maxtom400-lab/Electric-piano-tuning/notes/545.jpg

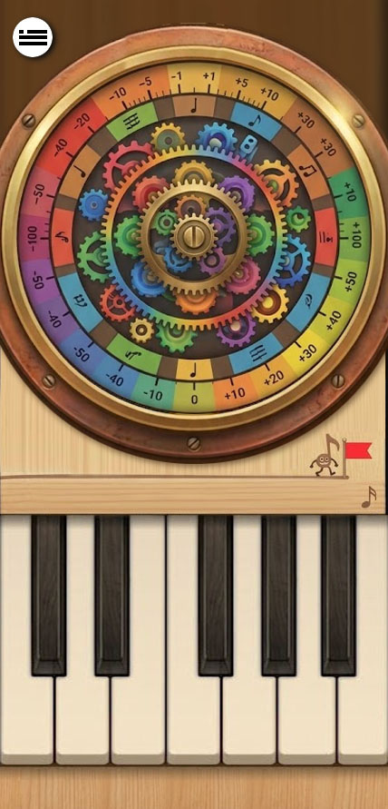
notes/545.jpg
