maxtom400-lab/Electric-piano-tuning/HARDWARE.md

# Hardware Reference

## Current ESP32-C3 Prototype

The current app and firmware target an ESP32-C3 SuperMini named `troy high school`, a separate 12V DC motor driver, and two limit switches connected directly to GPIO6/GPIO7. GPIO4/GPIO5 control the driver's IN1/IN2. A 12V-to-5V buck converter powers the ESP32; all grounds are common.

This new hardware combination awaits bench testing. The current timing model assumes 60 RPM, not the older 90 RPM value below. See [firmware wiring and test instructions](firmware/esp32_c3_piano_motor/README.md).

## Earlier Vendor-Board Setup

This project was developed and tested with a small BLE DC motor controller board and a 12V geared brushed DC motor.

## Purchase Reference Links

These links are provided only as purchase/reference information. Product pages, SKU names, and seller details may change over time.

- BLE motor driver board: https://item.taobao.com/item.htm?id=583203325716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
- 12V geared DC motor: https://item.taobao.com/item.htm?id=1038629212708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
- Piano rib mounting bracket: https://detail.tmall.com/item.htm?id=804404331380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

## Known BLE Board Details

- BLE name: `JUXUN-88888888`
- BLE address observed during testing: `DE:AB:BD:EA:2F:DE`
- Write characteristic: `0000ffe2-0000-1000-8000-00805f9b34fb`
- Notify characteristic: `0000ffe1-0000-1000-8000-00805f9b34fb`

See `PROTOCOL.md` for the actual command bytes, speed command, stop command, heartbeat, and left/right limit switch notifications.

## Motor Notes

- Motor type: 12V geared brushed DC motor
- Approximate speed used in the app safety text: 90 RPM
- The app uses hold-to-run manual controls and guarded automatic pulses.

## Mounting Notes

- The mounting bracket is intended to clamp/fix the mechanism to a piano rib.
- Verify that the bracket cannot slide before using automatic motor pulses.
- Do not rely on software limits alone; the mechanical setup should stay stable if the phone disconnects or the motor stops late.

## Safety

Piano tuning strings can break if the motor keeps pulling in the wrong direction. Always test with a safe mechanical setup, working limit switches, and a manual stop path.
