maxtom400-lab/Electric-piano-tuning/notes/ble-protocol.md

# BLE 协议记录

把 nRF Connect 或本 APP 发现的信息记录在这里。

```text
设备名: JUXUN-88888888
MAC 地址: DE:AB:BD:EA:2F:DE
Service UUID:
Characteristic UUID:
Properties: Write / Write Without Response / Notify

已从手机系统日志确认:

```text
控制 Service UUID: 0000ffe0-0000-1000-8000-00805f9b34fb
写入 Characteristic UUID: 0000ffe2-0000-1000-8000-00805f9b34fb
写入 Handle: 0x0021
写入属性: Write Without Response, prop=0x04
通知 Characteristic UUID: 0000ffe1-0000-1000-8000-00805f9b34fb
通知属性: Notify / Indicate, prop=0x18
店家微信小程序写入长度: 常见 8 字节或 9 字节
```

正转指令:
停止指令:
反转指令:
速度加:
速度减:
```
