maxtom400-lab/Electric-piano-tuning/docs/PIANO.docx

有刷电机性能参数，网址为参考地址：https://item.taobao.com/item.htm?id=1038629212708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

采用2头出轴的并且有M6螺纹的样式，电机与支架一起，支架固定在电机上，支架另一段可以安装卡住调律扳手的U型槽。电机参数：12v电源90转。

钢琴琴弦标准回转扭矩13 ~ 20 N·m维持音准所需的最小静摩擦阻力矩。通过“螺杆加长栓”结构将电机的旋转转化为直线运动，再通过 U 型卡槽推拉调律扳手。同时，利用带有自润滑圈的圆柱与台钳连接，完美解决了调律扳手在弧线运动时的多自由度释放（防止卡死）问题，橡胶垫设计也有效保护了钢琴昂贵的铸铁牌骨架。通过严密的力学和物理公式进行推导和计算：

一、 核心力学计算与可行性评估

1. 电机通过 M6 螺纹能产生多大推力（直线拉力）？

电机两端为 M6 螺栓轴。标准 M6 螺纹的螺距（Pitch）为 1 mm（即电机每转一圈，直线移动 1 毫米）。
根据机械传动公式，螺杆产生的直线推力 F 与输入扭矩 T 的关系为：

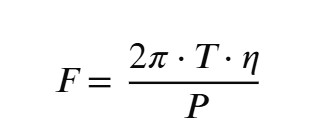
[picture p2: figure]

T (额定扭矩) = 2 kgf·cm = 0.196 N·m

- P (螺距) = 1 mm = 0.001 m
- η (由于是普通 M6 螺纹并非滚珠丝杠，滑动摩擦力较大，机械效率 η 约取 0.3)

代入公式计算：
N

- 额定状态下：电机能产生约 37 公斤（369 N） 的直线推力。
- 堵转状态下：扭矩提升 3 倍（6 kgf·cm），最大极限推力可达约 110 公斤。

2. 推力作用在调律扳手上，能产生多大调音扭矩？

根据上一轮的行业科普，钢琴调律需要 13 ~ 20 N·m 的回转扭矩。
假设您的 U 型卡槽固定在调律扳手柄的中后段（假设力臂 L = 0.2 米，即距离弦轴中心 20 厘米处）：

- 额定输出扭矩 = 369NX0.2m= 73.8 N·m
- 极限堵转扭矩 =110公斤X 0.2m≈220N·m
- 结论：动力完全过剩（绝对带得动）

调音仅需 13~20 N·m，而该电机通过 M6 螺纹放大后，额定即可输出 73.8 N·m 的扭矩。这意味着这款电机的力量绰绰有余，甚至可以轻松调准长期未调、极为紧实的高端新琴。

最大摆动角度： 8 厘米行程可带动的扳手最大摆角约为 23度（正负约 \11.5度）。

控制分辨率（每秒转角）： 电机每秒移动 1.16 毫米，对应扳手每秒仅转动 \0.33度

因为钢琴存在“音响不协和性”（Inharmonicity），高音需要偏高、低音需要偏低，不能照搬物理绝对频率。先录制 88 键，可以生成专属于这台钢琴的皮亚诺调律曲线（曲线拉伸图）。移植开源算法：关键两点

1、 录完 88 键后，App 应自动比对国际标准十二平均律（A4=440Hz）。

2、 算法将根据这台琴特有的物理状态（如弦长、张力），自动计算出高音区应调高多少音分（Cents），低音区应调低多少音分，形成一条平滑的调律曲线（Stretched Tuning Curve），作为下一步单独调律的目标基准线。

手机监听钢琴的频率，到达可接受范围停止调节，APP指针指向0的时候就说明该按键已经调节完毕。
