maxtom400-lab/Electric-piano-tuning/app/src/main/java/com/example/bluetoothmotor/MainActivity.java

package com.example.bluetoothmotor;

import android.Manifest;
import android.annotation.SuppressLint;
import android.app.Activity;
import android.app.AlertDialog;
import android.bluetooth.BluetoothAdapter;
import android.bluetooth.BluetoothDevice;
import android.bluetooth.BluetoothGatt;
import android.bluetooth.BluetoothGattCallback;
import android.bluetooth.BluetoothGattCharacteristic;
import android.bluetooth.BluetoothGattDescriptor;
import android.bluetooth.BluetoothGattService;
import android.bluetooth.BluetoothManager;
import android.bluetooth.BluetoothProfile;
import android.bluetooth.le.BluetoothLeScanner;
import android.bluetooth.le.ScanCallback;
import android.bluetooth.le.ScanResult;
import android.bluetooth.le.ScanSettings;
import android.content.Context;
import android.content.SharedPreferences;
import android.content.pm.PackageManager;
import android.graphics.Canvas;
import android.graphics.Color;
import android.graphics.Bitmap;
import android.graphics.BitmapFactory;
import android.graphics.Paint;
import android.graphics.LinearGradient;
import android.graphics.RadialGradient;
import android.graphics.Rect;
import android.graphics.RectF;
import android.graphics.Shader;
import android.media.AudioFormat;
import android.media.AudioManager;
import android.media.AudioRecord;
import android.media.AudioTrack;
import android.media.MediaRecorder;
import android.os.Build;
import android.os.Bundle;
import android.os.Handler;
import android.os.Looper;
import android.os.SystemClock;
import android.os.VibrationEffect;
import android.os.Vibrator;
import android.text.InputFilter;
import android.text.InputType;
import android.util.Log;
import android.view.Gravity;
import android.view.MotionEvent;
import android.view.View;
import android.widget.Button;
import android.widget.EditText;
import android.widget.LinearLayout;
import android.widget.ScrollView;
import android.widget.TextView;
import android.widget.Toast;

import java.io.ByteArrayOutputStream;
import java.io.IOException;
import java.io.InputStream;
import java.util.ArrayList;
import java.util.ArrayDeque;
import java.util.List;
import java.util.Locale;
import java.util.UUID;

public class MainActivity extends Activity {
    private static final String TAG = "PianoTuner";
    private static final int REQUEST_PERMISSIONS = 1001;
    private static final long SCAN_MS = 20_000L;
    private static final long HEARTBEAT_MS = 10 * 60 * 1000L;
    private static final int PIANO_SCAN_SAMPLES_REQUIRED = 3;
    private static final int SAMPLE_RATE = FftPitchDetector.SAMPLE_RATE;
    private static final int PITCH_BUFFER_SIZE = FftPitchDetector.FRAME_SIZE;
    private static final double TUNER_DIAL_CENTS_RANGE = 200.0;
    private static final float TUNER_DIAL_DEGREES_RANGE = 270f;
    private static final float TUNER_DIAL_DEGREES_PER_CENT =
            (float) (TUNER_DIAL_DEGREES_RANGE / TUNER_DIAL_CENTS_RANGE);
    private static final double AUTO_TOLERANCE_CENTS = 3.0;
    private static final int AUTO_MAX_STEPS = 40;
    private static final int AUTO_NOTE_WINDOW_SEMITONES = 2;
    private static final double EXPERIENCE_MOTOR_RPM = 60.0;
    private static final double EXPERIENCE_REV_MS = 60000.0 / EXPERIENCE_MOTOR_RPM;
    private static final double EXPERIENCE_PIN_DEGREES_PER_REV = 0.28;
    private static final double MOTOR_TOTAL_TRAVEL_REV = 40.0;
    private static final double MOTOR_INIT_BACKOFF_REV = 10.0;
    private static final long MOTOR_INIT_SEEK_TIMEOUT_MS = 120_000L;
    private static final long MOTOR_INIT_LIMIT_DEBOUNCE_MS = 1_000L;
    private static final double EXPERIENCE_LOW_CENTS_PER_REV = 2.8;
    private static final double EXPERIENCE_MID_CENTS_PER_REV = 4.5;
    private static final double EXPERIENCE_HIGH_CENTS_PER_REV = 12.6;
    private static final int EXPERIENCE_LOW_MIDI = 21;
    private static final int EXPERIENCE_MID_MIDI = 60;
    private static final int EXPERIENCE_HIGH_MIDI = 108;
    private static final int[] EXPERIENCE_CURVE_MIDI = {
            EXPERIENCE_LOW_MIDI,
            EXPERIENCE_MID_MIDI,
            EXPERIENCE_HIGH_MIDI
    };
    private static final double[] EXPERIENCE_CURVE_CENTS_PER_REV = {
            EXPERIENCE_LOW_CENTS_PER_REV,
            EXPERIENCE_MID_CENTS_PER_REV,
            EXPERIENCE_HIGH_CENTS_PER_REV
    };
    private static final int EXPERIENCE_MIN_PULSE_MS = 60;
    private static final int EXPERIENCE_DEFAULT_MAX_PULSE_MS = 12000;
    private static final double DEFAULT_PRELOAD_LOW_REV = 6.0;
    private static final long EXPERIENCE_RESTRIKE_ARM_MS = 450L;
    private static final int WRONG_KEY_ALLOWED_SEMITONES = 2;
    private static final long SAFETY_VIBRATION_COOLDOWN_MS = 900L;

    private enum Direction {
        NONE,
        LEFT,
        RIGHT
    }

    private static final String TARGET_NAME = "troy high school";

    private static final UUID WRITE_UUID =
            UUID.fromString("0000ffe2-0000-1000-8000-00805f9b34fb");
    private static final UUID NOTIFY_UUID =
            UUID.fromString("0000ffe1-0000-1000-8000-00805f9b34fb");
    private static final UUID CCCD_UUID =
            UUID.fromString("00002902-0000-1000-8000-00805f9b34fb");

    private static final String CMD_INIT = "AF010203040506FF";
    private static final String CMD_LEFT = "A1010100000002321F";
    private static final String CMD_STOP = "A10102000000011F";
    private static final String CMD_RIGHT = "A1020100000002321F";
    private static final String CMD_SPEED_50 = "A1080132";
    private static final String CMD_SPEED_30 = "A108011E";
    private static final String CMD_SPEED_STEP = CMD_SPEED_50;
    private static final String PREFS_NAME = "max_piano_tuner";

    private final Handler handler = new Handler(Looper.getMainLooper());
    private final SafeMotorSession safeMotor = new SafeMotorSession();
    private final PianoStrikeGate motorStrikeGate = new PianoStrikeGate();
    private final ArrayDeque<MotorWrite> motorWrites = new ArrayDeque<>();
    private MotorWrite activeMotorWrite;
    private long motorWriteTicket;
    private boolean activityPaused;

    private static final class MotorWrite {
        final String label;
        final byte[] payload;
        final int generation;
        final BluetoothGatt owner;
        final boolean stop;
        MotorWrite(String label, byte[] payload, int generation, BluetoothGatt owner, boolean stop) {
            this.label = label;
            this.payload = payload;
            this.generation = generation;
            this.owner = owner;
            this.stop = stop;
        }
    }
    private final Runnable heartbeatRunnable = new Runnable() {
        @Override
        public void run() {
            if (gatt != null && writeCharacteristic != null) {
                sendCommand("HEARTBEAT", CMD_INIT);
                handler.postDelayed(this, HEARTBEAT_MS);
            }
        }
    };

    private BluetoothAdapter adapter;
    private BluetoothLeScanner scanner;
    private BluetoothDevice targetDevice;
    private BluetoothGatt gatt;
    private BluetoothGattCharacteristic writeCharacteristic;
    private boolean scanning;
    private boolean connectAfterScan;
    private AlertDialog motorDialog;

    private TextView statusText;
    private TextView notifyText;
    private TextView pitchText;
    private TextView targetText;
    private TextView autoText;
    private SteampunkTunerView tunerView;
    private PianoKeyPlayer pianoKeyPlayer;
    private TextView logText;
    private EditText rawInput;
    private EditText repeatInput;
    private Runnable activeMotionRunnable;
    private int commandGeneration;
    private String pendingFreshLabel;
    private String pendingFreshHex;
    private long pendingFreshMotionDelayMs;
    private int pendingFreshRepeatCount;
    private long pendingFreshRepeatIntervalMs;
    private int pendingFreshSpeedCount;
    private long pendingFreshSpeedStartMs;
    private long pendingFreshSpeedIntervalMs;
    private long pendingFreshStopExtraMs;
    private boolean reconnectAfterDisconnect;
    private boolean pendingReplayVendorLr;
    private boolean replayVendorLrAfterInitAck;
    private Direction currentDirection = Direction.NONE;
    private Direction blockedDirection = Direction.NONE;
    private Direction motorSafetyBackoffOriginLimit = Direction.NONE;
    private long motorSafetySeekStartedAtMs;
    private AudioRecord audioRecord;
    private Thread audioThread;
    private volatile boolean listening;
    private volatile int audioGeneration;
    private volatile double latestFrequency;
    private volatile int latestMidi;
    private volatile double latestCents;
    private volatile long latestPitchMs;
    private volatile double latestStableFrequency;
    private volatile int latestStableMidi;
    private volatile double latestStableCents;
    private volatile long latestStablePitchMs;
    private int selectedTargetMidi = 60;
    private long suppressPitchUpdateUntilMs;
    private long suppressRangeAlarmUntilMs;
    private double pitchCandidateCents;
    private int pitchCandidateFrames;
    private long pitchCandidateStartedMs;
    private boolean autoTuning;
    private int autoGeneration;
    private int autoTargetMidi;
    private double autoTargetFrequency;
    private double autoProbeFrequency;
    private Direction autoRaiseDirection = Direction.NONE;
    private Direction autoLowerDirection = Direction.NONE;
    private int autoStepCount;
    private int autoSpeedPercent = 50;
    private int autoProbeMs = 350;
    private int autoPulseLongMs = 450;
    private int autoPulseMediumMs = 250;
    private int autoPulseShortMs = 120;
    private int autoSettleMs = 1400;
    private int autoMaxStepsSetting = AUTO_MAX_STEPS;
    private double autoToleranceCents = AUTO_TOLERANCE_CENTS;
    private int autoExperienceMaxPulseMs = EXPERIENCE_DEFAULT_MAX_PULSE_MS;
    private double autoPreloadLowRev = DEFAULT_PRELOAD_LOW_REV;
    private boolean autoWaitingForRestrike;
    private long autoIgnorePitchBeforeMs;
    private double autoLastObservedCents;
    private double autoLastExpectedDeltaCents;
    private int autoLastDurationMs;
    private Direction autoLastDirection = Direction.NONE;
    private final double[] autoExperienceScale = new double[109];
    private boolean motorSafetyInitInProgress;
    private boolean motorSafetyBackoffInProgress;
    private boolean motorSafetyInitialized;
    private int motorSafetyInitializedMidi;
    private double motorPositionRevFromLow = Double.NaN;
    private boolean autoArmedForPianoStrike;
    private long lastSafetyVibrateMs;
    private boolean keyPreviewEnabled;
    private long lastRangeAlarmVibrateMs;
    private AlertDialog pianoScanDialog;
    private TextView pianoScanStatusText;
    private TextView pianoScanProgressText;
    private boolean pianoScanActive;
    private int pianoScanMidi = 21;
    private int pianoScanCount;
    private long pianoScanLastRecordMs;
    private int pianoScanSampleCount;
    private String pianoScanQuality = "Waiting";
    private final boolean[] pianoScanRecorded = new boolean[109];
    private final double[] pianoScanFrequency = new double[109];
    private final double[] pianoScanCents = new double[109];
    private final double[] pianoScanSampleFrequency = new double[PIANO_SCAN_SAMPLES_REQUIRED];
    private final double[] pianoScanSampleCents = new double[PIANO_SCAN_SAMPLES_REQUIRED];
    private final double[] pianoTuningOffsetCents = new double[109];
    private boolean pianoTuningComputed;

    private final ScanCallback scanCallback = new ScanCallback() {
        @SuppressLint("MissingPermission")
        @Override
        public void onScanResult(int callbackType, ScanResult result) {
            BluetoothDevice device = result.getDevice();
            if (device == null || device.getAddress() == null) {
                return;
            }

            String name = safeDeviceName(device);
            String advertisedName = result.getScanRecord() == null ? null : result.getScanRecord().getDeviceName();
            String bestName = firstNonEmpty(advertisedName, name);
            boolean nameMatch = isTargetMotorName(name) || isTargetMotorName(advertisedName);
            if (bestName != null && (nameMatch || bestName.length() > 0)) {
                appendLogSafe(String.format(Locale.US,
                        "BLE scan %s name=%s adv=%s rssi=%d match=%s",
                        device.getAddress(),
                        valueOrDash(name),
                        valueOrDash(advertisedName),
                        result.getRssi(),
                        nameMatch));
            }
            if (!nameMatch) {
                return;
            }

            targetDevice = device;
            runOnUiThread(() -> {
                setStatus("已找到蓝牙电机板");
                appendLog("找到目标设备 " + deviceLabel(device));
                if (connectAfterScan) {
                    connectAfterScan = false;
                    stopScan();
                    showMotorDialog("正在连接蓝牙电机板...");
                    connectTarget();
                }
            });
        }

        @Override
        public void onScanFailed(int errorCode) {
            runOnUiThread(() -> {
                scanning = false;
                connectAfterScan = false;
                dismissMotorDialog();
                setStatus("蓝牙扫描失败: " + errorCode);
            });
        }
    };

    private final BluetoothGattCallback gattCallback = new BluetoothGattCallback() {
        @SuppressLint("MissingPermission")
        @Override
        public void onConnectionStateChange(BluetoothGatt owner, int status, int newState) {
            runOnUiThread(() -> {
                if (MainActivity.this.gatt != owner) {
                    if (newState == BluetoothProfile.STATE_DISCONNECTED) owner.close();
                    return;
                }
                if (newState == BluetoothProfile.STATE_CONNECTED && status == BluetoothGatt.GATT_SUCCESS && !activityPaused) {
                    setStatus("蓝牙已连接，正在发现服务");
                    showMotorDialog("正在发现电机服务...");
                    if (!owner.discoverServices()) motorTransportFailure("Service discovery rejected");
                } else if (newState == BluetoothProfile.STATE_DISCONNECTED) {
                    owner.close();
                    MainActivity.this.gatt = null;
                    writeCharacteristic = null;
                    motorWrites.clear();
                    activeMotorWrite = null;
                    motorWriteTicket++;
                    cancelScheduledCommands();
                    stopAutoTune(false);
                    clearMotorPosition();
                    safeMotor.disconnected();
                    stopHeartbeat();
                    dismissMotorDialog();
                    pendingFreshHex = null;
                    pendingReplayVendorLr = false;
                    reconnectAfterDisconnect = false;
                    setStatus("蓝牙已断开；重新连接后需要重新初始化");
                } else if (status != BluetoothGatt.GATT_SUCCESS || activityPaused) {
                    motorTransportFailure("Bluetooth connection failed: " + status);
                }
            });
        }

        @Override
        public void onServicesDiscovered(BluetoothGatt owner, int status) {
            runOnUiThread(() -> {
                if (owner != MainActivity.this.gatt || activityPaused) return;
                if (status != BluetoothGatt.GATT_SUCCESS) {
                    motorTransportFailure("Service discovery failed: " + status);
                    return;
                }
                BluetoothGattCharacteristic write = null;
                BluetoothGattCharacteristic notify = null;
                for (BluetoothGattService service : owner.getServices()) {
                    for (BluetoothGattCharacteristic c : service.getCharacteristics()) {
                        if (WRITE_UUID.equals(c.getUuid())) write = c;
                        if (NOTIFY_UUID.equals(c.getUuid())) notify = c;
                    }
                }
                if (write == null || notify == null
                        || (write.getProperties() & BluetoothGattCharacteristic.PROPERTY_WRITE) == 0) {
                    motorTransportFailure("Safe controller requires FFE2 write-with-response and FFE1 notifications");
                    return;
                }
                writeCharacteristic = write;
                enableNotifications(owner, notify);
            });
        }

        @Override
        public void onDescriptorWrite(BluetoothGatt owner, BluetoothGattDescriptor descriptor, int status) {
            runOnUiThread(() -> {
                if (owner != MainActivity.this.gatt || activityPaused) return;
                if (status != BluetoothGatt.GATT_SUCCESS || !CCCD_UUID.equals(descriptor.getUuid())) {
                    motorTransportFailure("Notification subscription failed: " + status);
                    return;
                }
                sendCommand("SAFE CAPABILITIES", SafeMotorSession.CAPABILITIES_HEX);
                startHeartbeat();
                dismissMotorDialog();
                setStatus("正在确认安全协议；未确认前禁止电机运动");
                handler.postDelayed(() -> {
                    if (owner == MainActivity.this.gatt && !safeMotor.capable() && !activityPaused) {
                        setStatus("未检测到安全协议，请升级 ESP32 固件；自动/手动电机控制已禁用");
                    }
                }, 2500L);
            });
        }

        @Override
        public void onCharacteristicWrite(BluetoothGatt owner, BluetoothGattCharacteristic characteristic, int status) {
            runOnUiThread(() -> {
                if (owner != MainActivity.this.gatt || activeMotorWrite == null
                        || activeMotorWrite.owner != owner) return;
                if (status != BluetoothGatt.GATT_SUCCESS) {
                    motorTransportFailure("BLE write failed: " + status);
                    return;
                }
                activeMotorWrite = null;
                motorWriteTicket++;
                pumpMotorWrites();
            });
        }

        @Override
        public void onCharacteristicChanged(
                BluetoothGatt gatt,
                BluetoothGattCharacteristic characteristic
        ) {
            handleNotifyValue(gatt, characteristic, characteristic.getValue());
        }

        @Override
        public void onCharacteristicChanged(
                BluetoothGatt gatt,
                BluetoothGattCharacteristic characteristic,
                byte[] value
        ) {
            handleNotifyValue(gatt, characteristic, value);
        }

    };

    @Override
    protected void onCreate(Bundle savedInstanceState) {
        super.onCreate(savedInstanceState);

        BluetoothManager manager = (BluetoothManager) getSystemService(Context.BLUETOOTH_SERVICE);
        adapter = manager == null ? null : manager.getAdapter();
        scanner = adapter == null ? null : adapter.getBluetoothLeScanner();
        pianoKeyPlayer = new PianoKeyPlayer(this);
        loadPianoScanData();
        loadCalibrationSettings();

        setContentView(buildContentView());
        requestNeededPermissions();
        if (hasAudioPermission()) {
            startPitchListening();
        }
    }

    @Override
    protected void onDestroy() {
        stopAutoTune(false);
        stopHeartbeat();
        stopPitchListening();
        stopScan();
        disconnectGatt();
        if (pianoKeyPlayer != null) {
            pianoKeyPlayer.release();
            pianoKeyPlayer = null;
        }
        super.onDestroy();
    }

    @Override
    protected void onPause() {
        activityPaused = true;
        stopPitchListening();
        cancelScheduledCommands();
        stopAutoTune(false);
        clearMotorPosition();
        motorWrites.clear();
        pendingFreshHex = null;
        pendingReplayVendorLr = false;
        reconnectAfterDisconnect = false;
        if (gatt != null) {
            sendCommand("BACKGROUND STOP", CMD_STOP);
            disconnectGatt();
        }
        super.onPause();
    }

    @Override
    protected void onResume() {
        super.onResume();
        activityPaused = false;
        if (hasAudioPermission() && tunerView != null) startPitchListening();
    }

    private View buildContentView() {
        ScrollView scrollView = new ScrollView(this);
        LinearLayout root = new LinearLayout(this);
        root.setOrientation(LinearLayout.VERTICAL);
        root.setPadding(0, 0, 0, 0);
        root.setBackgroundColor(Color.rgb(231, 204, 161));
        scrollView.addView(root);

        statusText = text("", 1, Color.TRANSPARENT, false);
        pitchText = text("", 1, Color.TRANSPARENT, false);
        targetText = text("", 1, Color.TRANSPARENT, false);
        autoText = text("", 1, Color.TRANSPARENT, false);
        notifyText = text("", 1, Color.TRANSPARENT, false);
        logText = text("", 1, Color.TRANSPARENT, false);

        tunerView = new SteampunkTunerView(this, this::handleVirtualPianoKeySelected, this::showControlPopup);
        root.addView(tunerView, new LinearLayout.LayoutParams(
                LinearLayout.LayoutParams.MATCH_PARENT,
                dp(860)
        ));

        selectTargetMidi(selectedTargetMidi);
        keyPreviewEnabled = true;

        scrollView.post(() -> scrollView.fullScroll(View.FOCUS_UP));
        return scrollView;
    }

    private TextView text(String value, int sp, int color, boolean bold) {
        TextView view = new TextView(this);
        view.setText(value);
        view.setTextSize(sp);
        view.setTextColor(color);
        view.setGravity(Gravity.START);
        view.setPadding(0, dp(6), 0, dp(6));
        if (bold) {
            view.setTypeface(android.graphics.Typeface.DEFAULT_BOLD);
        }
        return view;
    }

    private TextView label(String value) {
        return text(value, 14, Color.rgb(58, 72, 80), true);
    }

    private EditText editText(String value) {
        EditText input = new EditText(this);
        input.setSingleLine(true);
        input.setText(value);
        input.setFilters(new InputFilter[]{new InputFilter.AllCaps()});
        return input;
    }

    private LinearLayout row(View... children) {
        LinearLayout row = new LinearLayout(this);
        row.setOrientation(LinearLayout.HORIZONTAL);
        row.setGravity(Gravity.CENTER);
        row.setPadding(0, dp(4), 0, dp(4));
        for (View child : children) {
            row.addView(child);
        }
        return row;
    }

    private Button smallButton(String text, View.OnClickListener listener) {
        Button button = new Button(this);
        button.setText(text);
        button.setAllCaps(false);
        button.setTextSize(12);
        button.setTextColor(Color.rgb(45, 31, 20));
        button.setBackgroundColor(Color.rgb(219, 198, 166));
        button.setOnClickListener(listener);
        LinearLayout.LayoutParams params = new LinearLayout.LayoutParams(
                0,
                LinearLayout.LayoutParams.WRAP_CONTENT,
                1
        );
        params.setMargins(dp(3), dp(3), dp(3), dp(3));
        button.setLayoutParams(params);
        return button;
    }

    @SuppressLint("ClickableViewAccessibility")
    private Button holdButton(String text, String label, String hex) {
        Button button = smallButton(text, v -> {
        });
        button.setOnTouchListener((view, event) -> {
            switch (event.getActionMasked()) {
                case MotionEvent.ACTION_DOWN:
                    view.setPressed(true);
                    startHoldMotion(label, hex);
                    return true;
                case MotionEvent.ACTION_UP:
                case MotionEvent.ACTION_CANCEL:
                    view.setPressed(false);
                    stopHoldMotion(label);
                    return true;
                default:
                    return true;
            }
        });
        return button;
    }

    private Button popupButton(String text) {
        Button button = new Button(this);
        button.setText(text);
        button.setTextSize(18);
        button.setAllCaps(false);
        button.setTypeface(android.graphics.Typeface.DEFAULT_BOLD);
        button.setTextColor(Color.rgb(58, 38, 24));
        button.setBackgroundColor(Color.rgb(218, 178, 111));
        button.setMinHeight(dp(58));
        button.setElevation(dp(6));
        button.setPadding(dp(12), dp(8), dp(12), dp(8));
        LinearLayout.LayoutParams params = new LinearLayout.LayoutParams(
                LinearLayout.LayoutParams.MATCH_PARENT,
                LinearLayout.LayoutParams.WRAP_CONTENT
        );
        params.setMargins(0, dp(8), 0, dp(8));
        button.setLayoutParams(params);
        return button;
    }

    @SuppressLint("ClickableViewAccessibility")
    private void showControlPopup() {
        LinearLayout panel = new LinearLayout(this);
        panel.setOrientation(LinearLayout.VERTICAL);
        panel.setPadding(dp(22), dp(18), dp(22), dp(18));
        panel.setBackgroundColor(Color.rgb(232, 198, 139));

        Button connect = popupButton("连接蓝牙电机板");
        connect.setOnClickListener(v -> connectOnce());
        panel.addView(connect);

        Button left = popupButton("HOLD LEFT");
        left.setOnTouchListener((view, event) -> {
            switch (event.getActionMasked()) {
                case MotionEvent.ACTION_DOWN:
                    view.setPressed(true);
                    startHoldMotion("LEFT", CMD_LEFT);
                    return true;
                case MotionEvent.ACTION_UP:
                case MotionEvent.ACTION_CANCEL:
                    view.setPressed(false);
                    stopHoldMotion("LEFT");
                    return true;
                default:
                    return true;
            }
        });
        panel.addView(left);

        Button right = popupButton("HOLD RIGHT");
        right.setOnTouchListener((view, event) -> {
            switch (event.getActionMasked()) {
                case MotionEvent.ACTION_DOWN:
                    view.setPressed(true);
                    startHoldMotion("RIGHT", CMD_RIGHT);
                    return true;
                case MotionEvent.ACTION_UP:
                case MotionEvent.ACTION_CANCEL:
                    view.setPressed(false);
                    stopHoldMotion("RIGHT");
                    return true;
                default:
                    return true;
            }
        });
        panel.addView(right);

        Button record88 = popupButton("Record 88 Keys");
        record88.setOnClickListener(v -> showPianoScanDialog());
        panel.addView(record88);

        Button auto = popupButton("Auto Tune Selected Key");
        auto.setOnClickListener(v -> showAutoSafetyDialog());
        panel.addView(auto);

        Button stopAuto = popupButton("Stop Auto Tune");
        stopAuto.setOnClickListener(v -> stopAutoTune(true));
        panel.addView(stopAuto);

        Button calibration = popupButton("Calibration");
        calibration.setOnClickListener(v -> showCalibrationDialog());
        panel.addView(calibration);

        Button about = popupButton("About");
        about.setOnClickListener(v -> showAboutDialogClean());
        panel.addView(about);

        AlertDialog dialog = new AlertDialog.Builder(this)
                .setTitle("Motor Control")
                .setView(panel)
                .create();
        dialog.setOnDismissListener(d -> stopAllCommands());
        dialog.show();
    }

    private void showAboutDialog() {
        new AlertDialog.Builder(this)
                .setTitle("About")
                .setMessage("The motor is a 12V gear motor with a speed of 90 RPM. On the app's tuning dial, the 12 o'clock position (zero mark) indicates correct pitch; the range extends 170 degrees to the left and 170 degrees to the right, representing the full tuning span. The app will trigger an alarm if these limits are exceeded, so please adjust carefully—I accept no liability for broken strings.\n\nTORY HIGH SCHOOL MAX.YING 2026.")
                .setPositiveButton("OK", null)
                .show();
    }

    private void showAboutDialogClean() {
        new AlertDialog.Builder(this)
                .setTitle("About")
                .setMessage("The motor is a 12V gear motor with a speed of 90 RPM. On the app's tuning dial, the 12 o'clock position (zero mark) indicates correct pitch; the range extends 170 degrees to the left and 170 degrees to the right, representing the full tuning span. The app will trigger an alarm if these limits are exceeded, so please adjust carefully - I accept no liability for broken strings.\n\nTORY HIGH SCHOOL MAX.YING 2026.")
                .setPositiveButton("OK", null)
                .show();
    }

    private void showAutoSafetyDialog() {
        String note = noteName(selectedTargetMidi);
        new AlertDialog.Builder(this)
                .setTitle("Auto Tune Safety")
                .setMessage("Before starting automatic tuning:\n\n"
                        + "1. The piano rib bracket is locked and cannot slide.\n"
                        + "2. Left and right limit switches have been tested.\n"
                        + "3. Manual HOLD LEFT and HOLD RIGHT work correctly.\n"
                        + "4. The selected key is " + note + ". Play this key until the pitch display is stable.\n"
                        + "5. Experience mode assumes LEFT lowers pitch and RIGHT raises pitch.\n\n"
                        + "The app will calculate one motor move from the learned cents/rotation map, then wait for the next physical key strike to refine the next move. Stop immediately if the mechanism moves unexpectedly.")
                .setNegativeButton("Cancel", null)
                .setPositiveButton("Start Auto Tune", (dialog, which) -> startAutoTune())
                .show();
    }

    private void showCalibrationDialog() {
        LinearLayout panel = new LinearLayout(this);
        panel.setOrientation(LinearLayout.VERTICAL);
        panel.setPadding(dp(18), dp(14), dp(18), dp(14));
        panel.setBackgroundColor(Color.rgb(232, 198, 139));

        EditText speed = numberEditText(autoSpeedPercent);
        EditText probe = numberEditText(autoProbeMs);
        EditText pulseLong = numberEditText(autoPulseLongMs);
        EditText pulseMedium = numberEditText(autoPulseMediumMs);
        EditText pulseShort = numberEditText(autoPulseShortMs);
        EditText settle = numberEditText(autoSettleMs);
        EditText maxSteps = numberEditText(autoMaxStepsSetting);
        EditText tolerance = decimalEditText(autoToleranceCents);
        EditText experienceMaxPulse = numberEditText(autoExperienceMaxPulseMs);
        EditText preloadLow = decimalEditText(autoPreloadLowRev);

        panel.addView(label("Speed percent (1-100)"));
        panel.addView(speed);
        panel.addView(label("Probe pulse ms"));
        panel.addView(probe);
        panel.addView(label("Long pulse ms (>25 cents)"));
        panel.addView(pulseLong);
        panel.addView(label("Medium pulse ms (10-25 cents)"));
        panel.addView(pulseMedium);
        panel.addView(label("Short pulse ms (<10 cents)"));
        panel.addView(pulseShort);
        panel.addView(label("Settle time after pulse ms"));
        panel.addView(settle);
        panel.addView(label("Max auto steps"));
        panel.addView(maxSteps);
        panel.addView(label("Done tolerance cents"));
        panel.addView(tolerance);
        panel.addView(label("Experience one-shot max ms"));
        panel.addView(experienceMaxPulse);
        panel.addView(label("Preload low-direction revs"));
        panel.addView(preloadLow);

        new AlertDialog.Builder(this)
                .setTitle("Calibration")
                .setView(panel)
                .setNegativeButton("Cancel", null)
                .setNeutralButton("Defaults", (dialog, which) -> {
                    resetCalibrationDefaults();
                    saveCalibrationSettings();
                    toast("Calibration defaults restored");
                })
                .setPositiveButton("Save", (dialog, which) -> {
                    autoSpeedPercent = clampInt(parseInt(speed, autoSpeedPercent), 1, 100);
                    autoProbeMs = clampInt(parseInt(probe, autoProbeMs), 80, 1500);
                    autoPulseLongMs = clampInt(parseInt(pulseLong, autoPulseLongMs), 80, 1500);
                    autoPulseMediumMs = clampInt(parseInt(pulseMedium, autoPulseMediumMs), 60, 1000);
                    autoPulseShortMs = clampInt(parseInt(pulseShort, autoPulseShortMs), 40, 800);
                    autoSettleMs = clampInt(parseInt(settle, autoSettleMs), 500, 5000);
                    autoMaxStepsSetting = clampInt(parseInt(maxSteps, autoMaxStepsSetting), 3, 120);
                    autoToleranceCents = clampDouble(parseDouble(tolerance, autoToleranceCents), 0.5, 20.0);
                    autoExperienceMaxPulseMs = clampInt(parseInt(experienceMaxPulse, autoExperienceMaxPulseMs), 500, 60000);
                    autoPreloadLowRev = clampDouble(parseDouble(preloadLow, autoPreloadLowRev), 0.0, 10.0);
                    saveCalibrationSettings();
                    toast("Calibration saved");
                })
                .show();
    }

    private EditText numberEditText(int value) {
        EditText input = new EditText(this);
        input.setSingleLine(true);
        input.setText(String.valueOf(value));
        input.setInputType(InputType.TYPE_CLASS_NUMBER);
        return input;
    }

    private EditText decimalEditText(double value) {
        EditText input = new EditText(this);
        input.setSingleLine(true);
        input.setText(String.format(Locale.US, "%.1f", value));
        input.setInputType(InputType.TYPE_CLASS_NUMBER | InputType.TYPE_NUMBER_FLAG_DECIMAL);
        return input;
    }

    private void showPianoScanDialog() {
        LinearLayout panel = new LinearLayout(this);
        panel.setOrientation(LinearLayout.VERTICAL);
        panel.setPadding(dp(18), dp(14), dp(18), dp(14));
        panel.setBackgroundColor(Color.rgb(232, 198, 139));

        pianoScanStatusText = text("", 16, Color.rgb(45, 31, 20), true);
        pianoScanProgressText = text("", 13, Color.rgb(82, 56, 34), false);
        panel.addView(pianoScanStatusText);
        panel.addView(pianoScanProgressText);

        Button start = popupButton("Start / Resume Recording");
        start.setOnClickListener(v -> startPianoScan());
        panel.addView(start);

        Button prev = smallButton("Previous", v -> movePianoScanKey(-1));
        Button next = smallButton("Next", v -> movePianoScanKey(1));
        panel.addView(row(prev, next));

        Button compute = popupButton("Compute Tuning");
        compute.setOnClickListener(v -> computePianoTuningModel());
        panel.addView(compute);

        Button reset = popupButton("Reset Recording");
        reset.setOnClickListener(v -> resetPianoScan());
        panel.addView(reset);

        updatePianoScanDialog();
        pianoScanDialog = new AlertDialog.Builder(this)
                .setTitle("88-Key Recording")
                .setView(panel)
                .setPositiveButton("Close", null)
                .create();
        pianoScanDialog.setOnDismissListener(dialog -> pianoScanActive = false);
        pianoScanDialog.show();
    }

    private void startPianoScan() {
        if (!hasAudioPermission()) {
            requestNeededPermissions();
            return;
        }
        if (!listening) {
            startPitchListening();
        }
        if (pianoScanMidi < 21 || pianoScanMidi > 108) {
            pianoScanMidi = firstUnrecordedMidi();
        }
        pianoScanActive = true;
        resetPianoScanSamples("Waiting");
        selectTargetMidi(pianoScanMidi, false);
        updatePianoScanDialog();
    }

    private void resetPianoScan() {
        pianoScanActive = false;
        pianoScanMidi = 21;
        pianoScanCount = 0;
        pianoTuningComputed = false;
        resetPianoScanSamples("Waiting");
        for (int midi = 21; midi <= 108; midi++) {
            pianoScanRecorded[midi] = false;
            pianoScanFrequency[midi] = 0;
            pianoScanCents[midi] = 0;
            pianoTuningOffsetCents[midi] = 0;
        }
        savePianoScanData();
        selectTargetMidi(pianoScanMidi, false);
        updatePianoScanDialog();
    }

    private void movePianoScanKey(int delta) {
        pianoScanMidi = Math.max(21, Math.min(108, pianoScanMidi + delta));
        pianoScanActive = true;
        resetPianoScanSamples("Waiting");
        selectTargetMidi(pianoScanMidi, false);
        updatePianoScanDialog();
    }

    private void updatePianoScanDialog() {
        if (pianoScanStatusText == null || pianoScanProgressText == null) {
            return;
        }
        String state = pianoScanActive ? "Listening" : "Paused";
        String recorded = pianoScanRecorded[pianoScanMidi] ? "recorded" : "waiting";
        pianoScanStatusText.setText(String.format(Locale.US,
                "%s: play %s (%d/88, %s, %s)",
                state,
                noteName(pianoScanMidi),
                pianoScanMidi - 20,
                recorded,
                pianoScanQuality
        ));
        String model = pianoTuningComputed
                ? String.format(Locale.US, "Tuning map ready: %+.1f cents for %s",
                pianoTuningOffsetCents[pianoScanMidi],
                noteName(pianoScanMidi))
                : "Record all keys before computing";
        pianoScanProgressText.setText(String.format(Locale.US,
                "Recorded %d of 88 keys. %s.\nEach key needs %d stable samples; the median is saved automatically.",
                pianoScanCount,
                model,
                PIANO_SCAN_SAMPLES_REQUIRED
        ));
    }

    private int firstUnrecordedMidi() {
        for (int midi = 21; midi <= 108; midi++) {
            if (!pianoScanRecorded[midi]) {
                return midi;
            }
        }
        return 108;
    }

    private void handlePianoScanPitch(double frequency, int detectedMidi, double centsToTarget) {
        if (!pianoScanActive || pianoScanMidi < 21 || pianoScanMidi > 108) {
            return;
        }
        long now = System.currentTimeMillis();
        if (now - pianoScanLastRecordMs < 650L) {
            return;
        }
        if (Math.abs(detectedMidi - pianoScanMidi) > 1) {
            resetPianoScanSamples("Wrong key: heard " + noteName(detectedMidi));
            updatePianoScanDialog();
            return;
        }
        if (Math.abs(centsToTarget) > 150.0) {
            resetPianoScanSamples("Pitch too far: " + String.format(Locale.US, "%+.0f cents", centsToTarget));
            updatePianoScanDialog();
            return;
        }
        pianoScanSampleFrequency[pianoScanSampleCount] = frequency;
        pianoScanSampleCents[pianoScanSampleCount] = centsToTarget;
        pianoScanSampleCount++;
        pianoScanLastRecordMs = now;
        pianoScanQuality = String.format(Locale.US, "Sample %d/%d",
                pianoScanSampleCount,
                PIANO_SCAN_SAMPLES_REQUIRED);
        if (pianoScanSampleCount < PIANO_SCAN_SAMPLES_REQUIRED) {
            updatePianoScanDialog();
            return;
        }
        if (!pianoScanRecorded[pianoScanMidi]) {
            pianoScanRecorded[pianoScanMidi] = true;
            pianoScanCount++;
        }
        pianoScanFrequency[pianoScanMidi] = median3(pianoScanSampleFrequency);
        pianoScanCents[pianoScanMidi] = median3(pianoScanSampleCents);
        pianoScanQuality = String.format(Locale.US, "Recorded OK: %.2f Hz, %+.1f cents",
                pianoScanFrequency[pianoScanMidi],
                pianoScanCents[pianoScanMidi]);
        savePianoScanData();
        appendLog(String.format(Locale.US, "Recorded %s %.2f Hz %.1f cents",
                noteName(pianoScanMidi), pianoScanFrequency[pianoScanMidi], pianoScanCents[pianoScanMidi]));
        if (pianoScanMidi < 108) {
            pianoScanMidi++;
            resetPianoScanSamples("Waiting");
            selectTargetMidi(pianoScanMidi, false);
        } else {
            pianoScanActive = false;
            resetPianoScanSamples("Complete");
        }
        updatePianoScanDialog();
    }

    private void updatePianoScanNoPitch(float level) {
        if (!pianoScanActive || pianoScanSampleCount > 0) {
            return;
        }
        updatePianoScanWaitingQuality(level);
    }

    private void updatePianoScanUnstable(float level) {
        if (!pianoScanActive || pianoScanSampleCount > 0) {
            return;
        }
        updatePianoScanWaitingQuality(level);
    }

    private void updatePianoScanWaitingQuality(float level) {
        String next = level < 0.045f ? "Too quiet" : "Unstable pitch";
        if (!next.equals(pianoScanQuality)) {
            pianoScanQuality = next;
            updatePianoScanDialog();
        }
    }

    private void resetPianoScanSamples(String quality) {
        pianoScanSampleCount = 0;
        pianoScanQuality = quality;
        for (int i = 0; i < PIANO_SCAN_SAMPLES_REQUIRED; i++) {
            pianoScanSampleFrequency[i] = 0;
            pianoScanSampleCents[i] = 0;
        }
    }

    private double median3(double[] values) {
        double a = values[0];
        double b = values[1];
        double c = values[2];
        if (a > b) {
            double t = a;
            a = b;
            b = t;
        }
        if (b > c) {
            double t = b;
            b = c;
            c = t;
        }
        if (a > b) {
            b = a;
        }
        return b;
    }

    private void computePianoTuningModel() {
        if (pianoScanCount < 88) {
            toast(String.format(Locale.US, "Record all 88 keys first (%d/88)", pianoScanCount));
            updatePianoScanDialog();
            return;
        }
        for (int midi = 21; midi <= 108; midi++) {
            double x = (midi - 64.5) / 43.5;
            pianoTuningOffsetCents[midi] = 18.0 * x * x * x + 4.0 * x;
        }
        pianoTuningComputed = true;
        savePianoScanData();
        toast("Tuning map ready");
        selectTargetMidi(selectedTargetMidi, false);
        updatePianoScanDialog();
    }

    private void savePianoScanData() {
        SharedPreferences.Editor editor = getSharedPreferences(PREFS_NAME, MODE_PRIVATE).edit();
        editor.putInt("scan_count", pianoScanCount);
        editor.putInt("scan_midi", pianoScanMidi);
        editor.putBoolean("tuning_computed", pianoTuningComputed);
        for (int midi = 21; midi <= 108; midi++) {
            editor.putBoolean("rec_" + midi, pianoScanRecorded[midi]);
            editor.putString("freq_" + midi, String.format(Locale.US, "%.6f", pianoScanFrequency[midi]));
            editor.putString("cents_" + midi, String.format(Locale.US, "%.6f", pianoScanCents[midi]));
            editor.putString("offset_" + midi, String.format(Locale.US, "%.6f", pianoTuningOffsetCents[midi]));
        }
        editor.apply();
    }

    private void loadPianoScanData() {
        SharedPreferences prefs = getSharedPreferences(PREFS_NAME, MODE_PRIVATE);
        pianoScanCount = prefs.getInt("scan_count", 0);
        pianoScanMidi = prefs.getInt("scan_midi", 21);
        pianoTuningComputed = prefs.getBoolean("tuning_computed", false);
        int counted = 0;
        for (int midi = 21; midi <= 108; midi++) {
            pianoScanRecorded[midi] = prefs.getBoolean("rec_" + midi, false);
            pianoScanFrequency[midi] = parseStoredDouble(prefs, "freq_" + midi);
            pianoScanCents[midi] = parseStoredDouble(prefs, "cents_" + midi);
            pianoTuningOffsetCents[midi] = parseStoredDouble(prefs, "offset_" + midi);
            if (pianoScanRecorded[midi]) {
                counted++;
            }
        }
        pianoScanCount = counted;
        pianoScanMidi = Math.max(21, Math.min(108, pianoScanMidi));
    }

    private void loadCalibrationSettings() {
        SharedPreferences prefs = getSharedPreferences(PREFS_NAME, MODE_PRIVATE);
        autoSpeedPercent = clampInt(prefs.getInt("auto_speed_percent", autoSpeedPercent), 1, 100);
        autoProbeMs = clampInt(prefs.getInt("auto_probe_ms", autoProbeMs), 80, 1500);
        autoPulseLongMs = clampInt(prefs.getInt("auto_pulse_long_ms", autoPulseLongMs), 80, 1500);
        autoPulseMediumMs = clampInt(prefs.getInt("auto_pulse_medium_ms", autoPulseMediumMs), 60, 1000);
        autoPulseShortMs = clampInt(prefs.getInt("auto_pulse_short_ms", autoPulseShortMs), 40, 800);
        autoSettleMs = clampInt(prefs.getInt("auto_settle_ms", autoSettleMs), 500, 5000);
        autoMaxStepsSetting = clampInt(prefs.getInt("auto_max_steps", autoMaxStepsSetting), 3, 120);
        autoToleranceCents = clampDouble(parseStoredDouble(prefs, "auto_tolerance_cents", autoToleranceCents), 0.5, 20.0);
        autoExperienceMaxPulseMs = clampInt(prefs.getInt("auto_experience_max_pulse_ms", autoExperienceMaxPulseMs), 500, 60000);
        autoPreloadLowRev = clampDouble(parseStoredDouble(prefs, "auto_preload_low_rev", autoPreloadLowRev), 0.0, 10.0);
        for (int midi = 21; midi <= 108; midi++) {
            autoExperienceScale[midi] = clampDouble(parseStoredDouble(prefs, "auto_exp_scale_" + midi, 1.0), 0.25, 4.0);
        }
    }

    private void saveCalibrationSettings() {
        SharedPreferences.Editor editor = getSharedPreferences(PREFS_NAME, MODE_PRIVATE).edit();
        editor.putInt("auto_speed_percent", autoSpeedPercent);
        editor.putInt("auto_probe_ms", autoProbeMs);
        editor.putInt("auto_pulse_long_ms", autoPulseLongMs);
        editor.putInt("auto_pulse_medium_ms", autoPulseMediumMs);
        editor.putInt("auto_pulse_short_ms", autoPulseShortMs);
        editor.putInt("auto_settle_ms", autoSettleMs);
        editor.putInt("auto_max_steps", autoMaxStepsSetting);
        editor.putString("auto_tolerance_cents", String.format(Locale.US, "%.3f", autoToleranceCents));
        editor.putInt("auto_experience_max_pulse_ms", autoExperienceMaxPulseMs);
        editor.putString("auto_preload_low_rev", String.format(Locale.US, "%.3f", autoPreloadLowRev));
        for (int midi = 21; midi <= 108; midi++) {
            editor.putString("auto_exp_scale_" + midi, String.format(Locale.US, "%.6f", experienceScaleForMidi(midi)));
        }
        editor.apply();
    }

    private void resetCalibrationDefaults() {
        autoSpeedPercent = 50;
        autoProbeMs = 350;
        autoPulseLongMs = 450;
        autoPulseMediumMs = 250;
        autoPulseShortMs = 120;
        autoSettleMs = 1400;
        autoMaxStepsSetting = AUTO_MAX_STEPS;
        autoToleranceCents = AUTO_TOLERANCE_CENTS;
        autoExperienceMaxPulseMs = EXPERIENCE_DEFAULT_MAX_PULSE_MS;
        autoPreloadLowRev = DEFAULT_PRELOAD_LOW_REV;
        for (int midi = 21; midi <= 108; midi++) {
            autoExperienceScale[midi] = 1.0;
        }
    }

    private double parseStoredDouble(SharedPreferences prefs, String key) {
        return parseStoredDouble(prefs, key, 0);
    }

    private double parseStoredDouble(SharedPreferences prefs, String key, double fallback) {
        try {
            return Double.parseDouble(prefs.getString(key, String.valueOf(fallback)));
        } catch (NumberFormatException ex) {
            return fallback;
        }
    }

    private int parseInt(EditText input, int fallback) {
        try {
            return Integer.parseInt(input.getText().toString().trim());
        } catch (NumberFormatException ex) {
            return fallback;
        }
    }

    private double parseDouble(EditText input, double fallback) {
        try {
            return Double.parseDouble(input.getText().toString().trim());
        } catch (NumberFormatException ex) {
            return fallback;
        }
    }

    private int clampInt(int value, int min, int max) {
        return Math.max(min, Math.min(max, value));
    }

    private double clampDouble(double value, double min, double max) {
        return Math.max(min, Math.min(max, value));
    }

    private String speedCommandForPercent(int percent) {
        return String.format(Locale.US, "A10801%02X", clampInt(percent, 1, 100));
    }

    private int dp(int value) {
        return Math.round(value * getResources().getDisplayMetrics().density);
    }

    private void setStatus(String value) {
        statusText.setText(value);
    }

    private void showMotorDialog(String message) {
        if (isFinishing()) {
            return;
        }
        if (motorDialog == null) {
            motorDialog = new AlertDialog.Builder(this)
                    .setTitle("蓝牙电机板连接")
                    .setMessage(message)
                    .setNegativeButton("Cancel", (dialog, which) -> {
                        connectAfterScan = false;
                        stopScan();
                        disconnectGatt();
                    })
                    .create();
        } else {
            motorDialog.setMessage(message);
        }
        if (!motorDialog.isShowing()) {
            motorDialog.show();
        }
    }

    private void dismissMotorDialog() {
        if (motorDialog != null && motorDialog.isShowing()) {
            motorDialog.dismiss();
        }
    }

    private void startHeartbeat() {
        stopHeartbeat();
        if (gatt != null && writeCharacteristic != null) {
            appendLog("Heartbeat scheduled every 10 minutes");
            handler.postDelayed(heartbeatRunnable, HEARTBEAT_MS);
        }
    }

    private void stopHeartbeat() {
        handler.removeCallbacks(heartbeatRunnable);
    }

    private void appendLogSafe(String value) {
        runOnUiThread(() -> appendLog(value));
    }

    private void appendLog(String value) {
        String line = String.format(Locale.US, "%tT  %s\n", System.currentTimeMillis(), value);
        Log.d(TAG, value);
        logText.append(line);
    }

    private void handleNotifyValue(BluetoothGatt owner, BluetoothGattCharacteristic characteristic, byte[] value) {
        if (value == null) return;
        byte[] snapshot = value.clone();
        runOnUiThread(() -> {
            if (owner != gatt || activityPaused) return;
            handleEsp32StatusNotification(snapshot);
            handleLimitNotification(snapshot);
            String hex = toHex(snapshot);
            notifyText.setText("Notify: " + hex);
            appendLog("Notify " + characteristic.getUuid() + " = " + hex);
        });
    }

    private void handleEsp32StatusNotification(byte[] value) {
        String text = printableAscii(value);
        if (text == null) return;
        String clean = text.trim().toUpperCase(Locale.US);
        SafeMotorSession.Request request = safeMotor.pending();
        SafeMotorSession.Event event = safeMotor.status(clean, SystemClock.elapsedRealtime());
        if (event == SafeMotorSession.Event.FAULT) {
            failMotorSafety("ESP32 protection/invalid acknowledgement: " + clean, true);
        } else if (event == SafeMotorSession.Event.CAPABLE) {
            setStatus(safeMotor.supportsRatchet() ? "SAFE_V2 已确认（棘轮续调）；取下扳手后初始化" : "SAFE_V1 基础定时模式已确认；取下扳手后初始化");
        } else if (event == SafeMotorSession.Event.HOME_DONE) {
            finishMotorSafetyInitializationFromEsp32();
        } else if (event == SafeMotorSession.Event.HIGH_LIMIT) {
            motorSafetyInitialized = false;
            motorPositionRevFromLow = Double.NaN;
            currentDirection = Direction.NONE;
            autoLastDirection = Direction.NONE;
            latestStablePitchMs = 0;
            pitchCandidateFrames = 0;
            autoIgnorePitchBeforeMs = System.currentTimeMillis() + EXPERIENCE_RESTRIKE_ARM_MS;
            autoWaitingForRestrike = true;
            armMotorStrike(EXPERIENCE_RESTRIKE_ARM_MS);
            autoText.setText("High limit: strike the selected key to confirm remaining flat pitch");
            scheduleAuto(this::autoAdjustLoop, autoSettleMs);
        } else if (event == SafeMotorSession.Event.RATCHET_DONE) {
            motorPositionRevFromLow = 0.0;
            motorSafetyInitialized = true;
            motorSafetyInitializedMidi = autoTargetMidi;
            currentDirection = Direction.NONE;
            autoLastDirection = Direction.NONE;
            latestStablePitchMs = 0;
            pitchCandidateFrames = 0;
            autoIgnorePitchBeforeMs = System.currentTimeMillis() + EXPERIENCE_RESTRIKE_ARM_MS;
            autoWaitingForRestrike = true;
            armMotorStrike(EXPERIENCE_RESTRIKE_ARM_MS);
            autoText.setText("Ratchet return complete: strike the key before the next raising stroke");
            scheduleAuto(this::autoAdjustLoop, autoSettleMs);
        } else if (event == SafeMotorSession.Event.MOVE_DONE && request != null) {
            if (Double.isNaN(motorPositionRevFromLow)) {
                failMotorSafety("Completed move without a known home position", true);
                return;
            }
            Direction direction = request.direction == 1 ? Direction.LEFT : Direction.RIGHT;
            if (request.preloadMs > 0) {
                updateMotorPositionAfterMove(direction == Direction.LEFT ? Direction.RIGHT : Direction.LEFT, request.preloadMs);
            }
            updateMotorPositionAfterMove(direction, request.runMs);
            currentDirection = Direction.NONE;
            if (autoTuning) {
                autoWaitingForRestrike = true;
                latestStablePitchMs = 0;
                pitchCandidateFrames = 0;
                autoIgnorePitchBeforeMs = System.currentTimeMillis() + EXPERIENCE_RESTRIKE_ARM_MS;
                armMotorStrike(EXPERIENCE_RESTRIKE_ARM_MS);
                autoText.setText("Auto: controller stopped; play the physical key again");
                scheduleAuto(this::autoAdjustLoop, autoSettleMs);
            }
        } else if (event == SafeMotorSession.Event.STARTED || event == SafeMotorSession.Event.PROGRESS) {
            autoText.setText("ESP32: " + clean);
            setStatus("ESP32: " + clean);
        }
    }

    private int readRepeat() {
        try {
            return Math.max(1, Math.min(100, Integer.parseInt(repeatInput.getText().toString().trim())));
        } catch (NumberFormatException ex) {
            return 1;
        }
    }

    @SuppressLint("MissingPermission")
    private void startScan() {
        if (adapter == null || scanner == null) {
            toast("手机不支持 BLE 蓝牙");
            return;
        }
        if (!hasScanPermission()) {
            requestNeededPermissions();
            return;
        }

        stopScan();
        targetDevice = null;
        scanning = true;
        setStatus("正在搜索蓝牙电机板");
        appendLog("开始高强度 BLE 扫描");
        ScanSettings settings = new ScanSettings.Builder()
                .setScanMode(ScanSettings.SCAN_MODE_LOW_LATENCY)
                .setReportDelay(0L)
                .build();
        scanner.startScan(null, settings, scanCallback);
        handler.postDelayed(this::stopScan, SCAN_MS);
    }

    @SuppressLint("MissingPermission")
    private void stopScan() {
        if (scanner != null && scanning && hasScanPermission()) {
            scanner.stopScan(scanCallback);
            scanning = false;
            appendLog("扫描已停止");
            if (targetDevice == null) {
                if (connectAfterScan) {
                    connectAfterScan = false;
                    dismissMotorDialog();
                    toast("未找到蓝牙电机板");
                }
                setStatus("未找到蓝牙电机板");
            }
        }
    }

    @SuppressLint("MissingPermission")
    private void connectTarget() {
        if (!hasConnectPermission()) {
            requestNeededPermissions();
            return;
        }
        if (targetDevice == null) {
            toast("请先扫描到 " + TARGET_NAME);
            return;
        }

        if (gatt != null) {
            reconnectAfterDisconnect = true;
            requestGattDisconnect();
            return;
        }
        openGattConnection("正在连接 ");
    }

    private void connectOnce() {
        if (gatt != null) {
            appendLog("蓝牙已连接或正在连接");
            return;
        }
        showMotorDialog("正在搜索蓝牙电机板...");
        if (targetDevice == null) {
            stopScan();
            connectAfterScan = true;
            startScan();
            return;
        }
        connectTarget();
    }

    @SuppressLint("MissingPermission")
    private void openGattConnection(String prefix) {
        if (activityPaused) return;
        if (!hasConnectPermission()) {
            requestNeededPermissions();
            return;
        }
        if (targetDevice == null) {
            toast("请先扫描蓝牙电机板");
            return;
        }
        setStatus(prefix + "蓝牙电机板");
        appendLog(prefix + deviceLabel(targetDevice));
        clearMotorPosition();
        safeMotor.connected();
        motorWrites.clear();
        activeMotorWrite = null;
        motorWriteTicket++;
        gatt = targetDevice.connectGatt(this, false, gattCallback, BluetoothDevice.TRANSPORT_LE);
    }

    @SuppressLint("MissingPermission")
    private void disconnectGatt() {
        reconnectAfterDisconnect = false;
        stopHeartbeat();
        requestGattDisconnect();
    }

    @SuppressLint("MissingPermission")
    private void requestGattDisconnect() {
        stopHeartbeat();
        cancelScheduledCommands();
        stopAutoTune(false);
        clearMotorPosition();
        safeMotor.disconnected();
        motorWrites.clear();
        activeMotorWrite = null;
        motorWriteTicket++;
        BluetoothGatt currentGatt = gatt;
        if (currentGatt != null && hasConnectPermission()) {
            appendLog("Disconnect requested");
            currentGatt.disconnect();
            handler.postDelayed(() -> {
                if (gatt == currentGatt) {
                    appendLog("Disconnect timeout, closing GATT");
                    currentGatt.close();
                    gatt = null;
                    writeCharacteristic = null;
                    if (reconnectAfterDisconnect) {
                        reconnectAfterDisconnect = false;
                        openGattConnection("正在重新连接 ");
                    }
                }
            }, 1500L);
        } else {
            gatt = null;
            writeCharacteristic = null;
        }
    }

    @SuppressLint("MissingPermission")
    private void enableNotifications(BluetoothGatt gatt, BluetoothGattCharacteristic characteristic) {
        if (!hasConnectPermission()) {
            return;
        }
        boolean enabled = gatt.setCharacteristicNotification(characteristic, true);
        appendLogSafe("Notify enable=" + enabled);

        BluetoothGattDescriptor descriptor = characteristic.getDescriptor(CCCD_UUID);
        if (descriptor != null) {
            boolean started;
            if (Build.VERSION.SDK_INT >= Build.VERSION_CODES.TIRAMISU) {
                started = gatt.writeDescriptor(descriptor, BluetoothGattDescriptor.ENABLE_NOTIFICATION_VALUE) == BluetoothGatt.GATT_SUCCESS;
            } else {
                descriptor.setValue(BluetoothGattDescriptor.ENABLE_NOTIFICATION_VALUE);
                started = gatt.writeDescriptor(descriptor);
            }
            appendLogSafe("CCCD write started=" + started);
        }
    }

    private void sendMotion(String label, String hex) {
        beginCommandSequence();
        if (!prepareMotion(label, hex)) {
            return;
        }
        sendCommand(label, hex);
    }

    private void startHoldMotion(String label, String hex) {
        beginCommandSequence();
        if (!prepareMotion(label, hex)) {
            return;
        }
        int generation = commandGeneration;
        startContinuousCommand(label, hex, () -> generation == commandGeneration, generation);
    }

    private void stopHoldMotion(String label) {
        cancelScheduledCommands();
        currentDirection = Direction.NONE;
        sendCommand(label + " release STOP", CMD_STOP);
    }

    private void pulseMotion(String label, String hex, long durationMs) {
        beginCommandSequence();
        if (!prepareMotion(label, hex)) {
            return;
        }
        int generation = commandGeneration;
        startContinuousCommand(label, hex, () -> generation == commandGeneration, generation);
        handler.postDelayed(() -> {
            if (generation == commandGeneration) {
                cancelScheduledCommands();
                currentDirection = Direction.NONE;
                sendCommand(label + " pulse STOP", CMD_STOP);
            }
        }, durationMs);
    }

    private void primeMode() {
        beginCommandSequence();
        for (int i = 0; i < 6; i++) {
            int step = i + 1;
            scheduleCommand("PRIME " + step + "/6", CMD_STOP, i * 1000L);
        }
    }

    private void sourceReady() {
        beginCommandSequence();
        sendCommand("SPEED" + autoSpeedPercent, speedCommandForPercent(autoSpeedPercent));
    }

    private void continuousMotionReady() {
        beginCommandSequence();
        sendCommand("SPEED" + autoSpeedPercent, speedCommandForPercent(autoSpeedPercent));
    }

    private void primeThenPulse(String label, String hex) {
        beginCommandSequence();
        for (int i = 0; i < 6; i++) {
            int step = i + 1;
            scheduleCommand("PRIME " + step + "/6", CMD_STOP, i * 1000L);
        }
        scheduleRunnable(() -> pulseMotion(label, hex, 1000), 6500L);
    }

    private void warmThenPulse(String label, String hex) {
        beginCommandSequence();
        scheduleSpeedSteps(20, 0L);
        scheduleRunnable(() -> pulseMotion(label, hex, 1000), 3800L);
    }

    private void vendorSpeed30Pulse(String label, String hex) {
        beginCommandSequence();
        sendCommand(label + " INIT", CMD_INIT);
        for (int i = 0; i < 20; i++) {
            int step = i + 1;
            scheduleCommand(label + " SPEED30 " + step + "/20", CMD_SPEED_STEP, 1000L + i * 180L);
        }
        long motionStart = 1000L + 20L * 180L + 380L;
        for (int i = 0; i < 8; i++) {
            int frame = i + 1;
            scheduleCommand(label + " frame " + frame + "/8", hex, motionStart + i * 138L);
        }
        scheduleCommand(label + " STOP", CMD_STOP, motionStart + 8L * 138L + 50L);
    }

    private void vendorExactSpeed30Pulse(String label, String hex) {
        beginCommandSequence();
        sendCommand(label + " INIT", CMD_INIT);
        long speedStart = 11_400L;
        for (int i = 0; i < 20; i++) {
            int step = i + 1;
            scheduleCommand(label + " SPEED30 " + step + "/20", CMD_SPEED_STEP, speedStart + i * 180L);
        }
        long motionStart = speedStart + 20L * 180L + 380L;
        for (int i = 0; i < 8; i++) {
            int frame = i + 1;
            scheduleCommand(label + " frame " + frame + "/8", hex, motionStart + i * 138L);
        }
        scheduleCommand(label + " STOP", CMD_STOP, motionStart + 8L * 138L + 50L);
    }

    private void vendorMinimalSpeed50Pulse(String label, String hex) {
        beginCommandSequence();
        sendCommand(label + " INIT", CMD_INIT);
        scheduleCommand(label + " ONCE", hex, 4520L);
        scheduleCommand(label + " STOP", CMD_STOP, 6250L);
    }

    private void freshConnectPulse(String label, String hex) {
        freshConnectPulse(label, hex, 900L);
    }

    private void freshConnectPulse(String label, String hex, long motionDelayMs) {
        freshConnectSequence(label, hex, motionDelayMs, 1, 0L);
    }

    private void freshConnectBurst(String label, String hex) {
        freshConnectSequence(label, hex, 4670L, 8, 138L);
    }

    private void freshConnectSequence(String label, String hex, long motionDelayMs, int repeatCount, long repeatIntervalMs) {
        freshConnectSequence(label, hex, motionDelayMs, repeatCount, repeatIntervalMs, 0, 0L, 0L, 50L);
    }

    private void freshConnectSpeedBurst(String label, String hex) {
        freshConnectSequence(label, hex, 4980L, 8, 138L, 20, 1000L, 180L, 50L);
    }

    private void freshConnectStorePulse(String label, String hex) {
        freshConnectSequence(label, hex, 1510L, 2, 130L, 0, 0L, 0L, 1450L);
    }

    private void liveBurst(String label, String hex) {
        beginCommandSequence();
        if (!prepareMotion(label, hex)) {
            return;
        }
        for (int i = 0; i < 8; i++) {
            scheduleCommand(label + " " + (i + 1) + "/8", hex, i * 138L);
        }
        scheduleCommand(label + " STOP", CMD_STOP, 8L * 138L + 50L);
        scheduleRunnable(() -> currentDirection = Direction.NONE, 8L * 138L + 80L);
    }

    private void liveStorePulse(String label, String hex) {
        beginCommandSequence();
        if (!prepareMotion(label, hex)) {
            return;
        }
        sendCommand(label + " 1/2", hex);
        scheduleCommand(label + " 2/2", hex, 130L);
        scheduleCommand(label + " STOP", CMD_STOP, 1600L);
        scheduleRunnable(() -> currentDirection = Direction.NONE, 1650L);
    }

    private void freshReplayVendorLr() {
        beginCommandSequence();
        if (targetDevice == null) {
            toast("Scan first");
            return;
        }
        pendingReplayVendorLr = true;
        appendLog("Replay vendor LR queued");
        if (gatt != null) {
            reconnectAfterDisconnect = true;
            requestGattDisconnect();
        } else {
            scheduleRunnable(() -> openGattConnection("正在连接 "), 650L);
        }
    }

    private void scheduleVendorLrReplay(long firstDelayMs) {
        scheduleCommand("REPLAY LEFT 1/2", CMD_LEFT, firstDelayMs);
        scheduleCommand("REPLAY LEFT 2/2", CMD_LEFT, firstDelayMs + 130L);
        scheduleCommand("REPLAY LEFT STOP", CMD_STOP, firstDelayMs + 1379L);
        scheduleCommand("REPLAY RIGHT 1/2", CMD_RIGHT, firstDelayMs + 2675L);
        scheduleCommand("REPLAY RIGHT 2/2", CMD_RIGHT, firstDelayMs + 2806L);
        scheduleCommand("REPLAY RIGHT STOP", CMD_STOP, firstDelayMs + 4474L);
    }

    private void freshConnectSequence(
            String label,
            String hex,
            long motionDelayMs,
            int repeatCount,
            long repeatIntervalMs,
            int speedCount,
            long speedStartMs,
            long speedIntervalMs,
            long stopExtraMs
    ) {
        beginCommandSequence();
        if (targetDevice == null) {
            toast("Scan first");
            return;
        }
        pendingFreshLabel = label;
        pendingFreshHex = hex;
        pendingFreshMotionDelayMs = motionDelayMs;
        pendingFreshRepeatCount = Math.max(1, repeatCount);
        pendingFreshRepeatIntervalMs = Math.max(0L, repeatIntervalMs);
        pendingFreshSpeedCount = Math.max(0, speedCount);
        pendingFreshSpeedStartMs = Math.max(0L, speedStartMs);
        pendingFreshSpeedIntervalMs = Math.max(0L, speedIntervalMs);
        pendingFreshStopExtraMs = Math.max(50L, stopExtraMs);
        appendLog(label + " fresh reconnect queued");
        if (gatt != null) {
            reconnectAfterDisconnect = true;
            requestGattDisconnect();
        } else {
            scheduleRunnable(() -> openGattConnection("正在连接 "), 650L);
        }
    }

    private boolean prepareMotion(String label, String hex) {
        Direction direction = directionForHex(hex);
        if (direction == Direction.NONE) return true;
        if (!safeMotor.capable() || activityPaused) {
            toast("Safe protocol not ready; manual motion blocked");
            return false;
        }
        if (safeMotor.pending() != null) {
            failMotorSafety("Manual override: stop and release before continuing", true);
            return false;
        }
        stopAutoTune(false);
        clearMotorPosition();
        if (blockedDirection == direction) {
            setStatus(directionName(direction) + " limit is active; use opposite direction");
            return false;
        }
        currentDirection = direction;
        appendLog(label + " direction=" + directionName(direction));
        return true;
    }

    private Direction directionForHex(String hex) {
        String clean = hex == null ? "" : hex.replaceAll("[^0-9A-Fa-f]", "").toUpperCase(Locale.US);
        if (CMD_LEFT.equalsIgnoreCase(clean)) {
            return Direction.LEFT;
        }
        if (CMD_RIGHT.equalsIgnoreCase(clean)) {
            return Direction.RIGHT;
        }
        return Direction.NONE;
    }

    private void handleLimitNotification(byte[] data) {
        if (data == null || data.length < 3 || (data[0] & 0xFF) != 0xA1) {
            return;
        }
        String clean = toHex(data).replace(" ", "");
        if (clean.startsWith("A1010100000002")
                || clean.startsWith("A1020100000002")
                || clean.startsWith("A1010200000001")
                || clean.startsWith("A1010100000003")
                || clean.startsWith("A1020100000003")
                || clean.startsWith("A1010200000003")) {
            return;
        }

        int channel = data[1] & 0xFF;
        int state = data[2] & 0xFF;
        Direction limitDirection;
        if (channel == 0x01) {
            limitDirection = Direction.LEFT;
        } else if (channel == 0x02) {
            limitDirection = Direction.RIGHT;
        } else {
            return;
        }

        if (state == 0x01) {
            onLimitActive(limitDirection);
        } else if (state == 0x02) {
            onLimitReleased(limitDirection);
        }
    }

    private void onLimitActive(Direction limitDirection) {
        blockedDirection = limitDirection;
        appendLog(directionName(limitDirection) + " limit active");
        SafeMotorSession.Request request = safeMotor.pending();
        if (request != null && (request.kind == SafeMotorSession.Kind.HOME
                || request.kind == SafeMotorSession.Kind.RATCHET)) {
            setStatus("Init: controller limit event " + directionName(limitDirection));
            return;
        }
        if (safeMotor.supportsRatchet() && limitDirection == Direction.RIGHT
                && ((request != null && request.kind == SafeMotorSession.Kind.MOVE && request.direction == 2)
                    || safeMotor.ratchetEligible())) {
            setStatus("High limit: waiting for tagged controller result / remeasurement");
            return;
        }
        if (safeMotor.supportsRatchet() && limitDirection == Direction.LEFT && motorPositionRevFromLow == 0.0
                && (request == null || (request.kind == SafeMotorSession.Kind.MOVE
                    && request.direction == 2 && request.preloadMs == 0))) {
            setStatus("Ratchet low origin; controller must confirm release on raising");
            return;
        }
        if (request != null || autoTuning || currentDirection != Direction.NONE) {
            failMotorSafety("Limit active: " + directionName(limitDirection), true);
        } else setStatus(directionName(limitDirection) + " limit active");
    }

    private void onLimitReleased(Direction limitDirection) {
        if (blockedDirection == limitDirection) {
            blockedDirection = Direction.NONE;
        }
        appendLogSafe(directionName(limitDirection) + " limit released");
    }

    private String directionName(Direction direction) {
        if (direction == Direction.LEFT) {
            return "Left";
        }
        if (direction == Direction.RIGHT) {
            return "Right";
        }
        return "None";
    }

    private void beginCommandSequence() {
        cancelScheduledCommands();
        commandGeneration++;
    }

    private void stopAllCommands() {
        cancelScheduledCommands();
        currentDirection = Direction.NONE;
        pendingFreshLabel = null;
        pendingFreshHex = null;
        pendingFreshMotionDelayMs = 0L;
        pendingFreshRepeatCount = 1;
        pendingFreshRepeatIntervalMs = 0L;
        pendingFreshSpeedCount = 0;
        pendingFreshSpeedStartMs = 0L;
        pendingFreshSpeedIntervalMs = 0L;
        pendingFreshStopExtraMs = 50L;
        pendingReplayVendorLr = false;
        replayVendorLrAfterInitAck = false;
        reconnectAfterDisconnect = false;
        sendCommand("STOP", CMD_STOP);
    }

    private void cancelScheduledCommands() {
        if (activeMotionRunnable != null) {
            handler.removeCallbacks(activeMotionRunnable);
            activeMotionRunnable = null;
        }
        commandGeneration++;
    }

    private void scheduleRunnable(Runnable runnable, long delayMs) {
        int generation = commandGeneration;
        handler.postDelayed(() -> {
            if (generation == commandGeneration) {
                runnable.run();
            }
        }, delayMs);
    }

    private void scheduleCommand(String label, String hex, long delayMs) {
        int generation = commandGeneration;
        handler.postDelayed(() -> {
            if (generation == commandGeneration) {
                sendCommand(label, hex);
            }
        }, delayMs);
    }

    private void scheduleSpeedSteps(int count, long startDelayMs) {
        int safeCount = Math.max(1, Math.min(100, count));
        for (int i = 0; i < safeCount; i++) {
            int step = i + 1;
            scheduleCommand(
                    "SPEED " + step + "/" + safeCount,
                    CMD_SPEED_STEP,
                    startDelayMs + i * 180L
            );
        }
    }

    private void sendSpeedSteps(int count) {
        beginCommandSequence();
        scheduleSpeedSteps(count, 0L);
    }

    @SuppressLint("MissingPermission")
    private boolean sendCommand(String label, String rawHex) {
        if (Looper.myLooper() != Looper.getMainLooper()) {
            throw new IllegalStateException("Motor writes must be serialized on the UI thread");
        }
        if (gatt == null || writeCharacteristic == null || !hasConnectPermission()) return false;
        byte[] payload;
        try { payload = parseHex(rawHex); }
        catch (IllegalArgumentException ex) { toast(ex.getMessage()); return false; }
        String hex = toHex(payload).replace(" ", "");
        boolean stop = CMD_STOP.equals(hex) || "A10202000000011F".equals(hex);
        boolean query = SafeMotorSession.CAPABILITIES_HEX.equals(hex) || CMD_INIT.equals(hex);
        if ((activityPaused && !stop) || (!stop && !query && !safeMotor.capable())) {
            setStatus("Safe protocol not ready; motor command blocked");
            return false;
        }
        boolean taggedMotion = hex.startsWith("A1F2") || hex.startsWith("A1F3") || (hex.startsWith("A1F1") && !query);
        if (taggedMotion && (safeMotor.pending() == null || !safeMotor.pending().hex().equals(hex))) {
            failMotorSafety("Untracked raw HOME/MOVE blocked", true);
            return false;
        }
        if (stop) {
            stopAutoTune(false);
            motorWrites.clear();
            if (safeMotor.pending() != null || safeMotor.ratchetEligible()) clearMotorPosition();
        }
        // Raw/manual HOLD must never preserve a stale automatic position.
        if (hex.startsWith("A10101") || hex.startsWith("A10201")) {
            if (safeMotor.pending() != null) {
                failMotorSafety("Manual command attempted during automatic motion", true);
                return false;
            }
            stopAutoTune(false);
            clearMotorPosition();
            currentDirection = hex.startsWith("A10101") ? Direction.LEFT : Direction.RIGHT;
        }
        if (motorWrites.size() >= 16) {
            motorTransportFailure("Motor write queue overflow");
            return false;
        }
        MotorWrite write = new MotorWrite(label, payload, commandGeneration, gatt, stop);
        if (stop) motorWrites.addFirst(write); else motorWrites.addLast(write);
        pumpMotorWrites();
        return gatt != null;
    }

    @SuppressLint("MissingPermission")
    private void pumpMotorWrites() {
        if (activeMotorWrite != null || gatt == null || writeCharacteristic == null) return;
        while (!motorWrites.isEmpty()) {
            MotorWrite write = motorWrites.removeFirst();
            if (write.owner != gatt || (!write.stop && (write.generation != commandGeneration || activityPaused))) continue;
            activeMotorWrite = write;
            long ticket = ++motorWriteTicket;
            boolean started;
            try {
                writeCharacteristic.setWriteType(BluetoothGattCharacteristic.WRITE_TYPE_DEFAULT);
                writeCharacteristic.setValue(write.payload);
                started = gatt.writeCharacteristic(writeCharacteristic);
            } catch (RuntimeException ex) {
                started = false;
            }
            appendLog(write.label + " -> " + toHex(write.payload) + " started=" + started);
            if (!started) { motorTransportFailure("Motor BLE write rejected (no retry)"); return; }
            handler.postDelayed(() -> {
                if (activeMotorWrite == write && ticket == motorWriteTicket) {
                    motorTransportFailure("Motor BLE write acknowledgement timeout (no retry)");
                }
            }, 1500L);
            return;
        }
    }

    private void clearMotorPosition() {
        motorStrikeGate.cancel();
        safeMotor.invalidate();
        motorSafetyInitialized = false;
        motorSafetyInitInProgress = false;
        motorSafetyBackoffInProgress = false;
        motorSafetyBackoffOriginLimit = Direction.NONE;
        motorPositionRevFromLow = Double.NaN;
        autoArmedForPianoStrike = false;
    }

    private void failMotorSafety(String reason, boolean sendStop) {
        cancelScheduledCommands();
        stopAutoTune(false);
        clearMotorPosition();
        motorWrites.clear();
        pendingFreshHex = null;
        pendingReplayVendorLr = false;
        if (sendStop && gatt != null) sendCommand("SAFETY STOP", CMD_STOP);
        appendLog(reason);
        setStatus("Safety stop: " + reason + "; rehome required");
        autoText.setText("Auto stopped: " + reason);
        triggerSafetyVibration(reason);
    }

    private void motorTransportFailure(String reason) {
        motorWrites.clear();
        activeMotorWrite = null;
        motorWriteTicket++;
        failMotorSafety(reason, false);
        safeMotor.disconnected();
        disconnectGatt();
    }

    private void watchMotorRequest(SafeMotorSession.Request request, BluetoothGatt owner) {
        handler.postDelayed(() -> {
            if (owner != gatt || safeMotor.pending() != request) return;
            if (safeMotor.expire(SystemClock.elapsedRealtime())) {
                failMotorSafety("Controller START/DONE timeout; move will not be retried", true);
                return;
            }
            watchMotorRequest(request, owner);
        }, 200L);
    }

    private byte[] parseHex(String value) {
        String clean = value.replace("0x", "")
                .replace("0X", "")
                .replaceAll("[^0-9A-Fa-f]", "");
        if (clean.length() == 0) {
            throw new IllegalArgumentException("Empty hex");
        }
        if (clean.length() % 2 != 0) {
            throw new IllegalArgumentException("Hex length must be even");
        }

        byte[] data = new byte[clean.length() / 2];
        for (int i = 0; i < clean.length(); i += 2) {
            data[i / 2] = (byte) Integer.parseInt(clean.substring(i, i + 2), 16);
        }
        return data;
    }

    private String toHex(byte[] data) {
        StringBuilder builder = new StringBuilder();
        for (byte b : data) {
            if (builder.length() > 0) {
                builder.append(' ');
            }
            builder.append(String.format(Locale.US, "%02X", b & 0xFF));
        }
        return builder.toString();
    }

    private boolean isInitAck(byte[] data) {
        return data != null
                && data.length >= 3
                && (data[0] & 0xFF) == 0xAF
                && (data[1] & 0xFF) == 0xA6
                && (data[2] & 0xFF) == 0x01;
    }

    private String printableAscii(byte[] data) {
        if (data == null || data.length == 0) {
            return null;
        }
        StringBuilder builder = new StringBuilder(data.length);
        for (byte b : data) {
            int value = b & 0xFF;
            if (value == '\r' || value == '\n' || value == '\t') {
                builder.append((char) value);
                continue;
            }
            if (value < 0x20 || value > 0x7E) {
                return null;
            }
            builder.append((char) value);
        }
        return builder.toString();
    }

    @SuppressLint("MissingPermission")
    private void startPitchListening() {
        if (listening) {
            return;
        }
        if (!hasAudioPermission()) {
            requestNeededPermissions();
            return;
        }

        int minBuffer = AudioRecord.getMinBufferSize(
                SAMPLE_RATE,
                AudioFormat.CHANNEL_IN_MONO,
                AudioFormat.ENCODING_PCM_16BIT
        );
        int bufferSize = Math.max(minBuffer, PITCH_BUFFER_SIZE * 2);
        audioRecord = new AudioRecord(
                MediaRecorder.AudioSource.MIC,
                SAMPLE_RATE,
                AudioFormat.CHANNEL_IN_MONO,
                AudioFormat.ENCODING_PCM_16BIT,
                bufferSize
        );
        if (audioRecord.getState() != AudioRecord.STATE_INITIALIZED) {
            toast("Microphone init failed");
            return;
        }

        listening = true;
        audioRecord.startRecording();
        final AudioRecord recorder = audioRecord;
        final int generation = ++audioGeneration;
        audioThread = new Thread(() -> {
            // Each recording generation owns its DSP state; no mutable buffers cross to UI.
            FftPitchDetector detector = new FftPitchDetector();
            PcmFrameBuffer frames = new PcmFrameBuffer(PITCH_BUFFER_SIZE, PianoStrikeGate.MAX_FRAME_GAP_MS);
            short[] buffer = frames.samples();
            while (listening && generation == audioGeneration) {
                int read;
                try { read = recorder.read(buffer, frames.offset(), frames.remaining()); }
                catch (IllegalStateException ex) { break; }
                long capturedAt = SystemClock.elapsedRealtime();
                if (read <= 0) break;
                boolean full;
                try { full = frames.commitRead(read, capturedAt); }
                catch (IllegalArgumentException ex) { break; }
                if (full) {
                    double frequency = detector.detect(buffer, PITCH_BUFFER_SIZE);
                    float level = computeLevel(buffer, PITCH_BUFFER_SIZE);
                    final boolean discontinuity = frames.discontinuity();
                    frames.consume();
                    runOnUiThread(() -> {
                        if (!listening || activityPaused || generation != audioGeneration) return;
                        long now = SystemClock.elapsedRealtime();
                        if (discontinuity) {
                            pitchCandidateFrames = 0;
                            if ((autoTuning || autoArmedForPianoStrike) && safeMotor.pending() == null) armMotorStrike(0);
                        }
                        if (now - capturedAt > PianoStrikeGate.MAX_FRAME_GAP_MS) {
                            if ((autoTuning || autoArmedForPianoStrike) && safeMotor.pending() == null) armMotorStrike(0);
                            return;
                        }
                        if (motorStrikeGate.observe(capturedAt, level)) pitchCandidateFrames = 0;
                        if (frequency > 0) {
                            updatePitch(frequency, level, null, 0);
                        } else if (tunerView != null) {
                            pitchCandidateFrames = 0;
                            tunerView.setWaveform(level, null, 0);
                            updatePianoScanNoPitch(level);
                        }
                    });
                }
            }
            runOnUiThread(() -> {
                if (listening && generation == audioGeneration) {
                    listening = false;
                    motorStrikeGate.cancel();
                    if (autoTuning || safeMotor.pending() != null) failMotorSafety("Audio stream stopped", true);
                }
            });
        }, "MAX-Pitch");
        audioThread.start();
    }

    private void stopPitchListening() {
        listening = false;
        audioGeneration++;
        motorStrikeGate.cancel();
        if (audioRecord != null) {
            try {
                audioRecord.stop();
            } catch (IllegalStateException ignored) {
            }
            audioRecord.release();
            audioRecord = null;
        }
        audioThread = null;
    }

    private float computeLevel(short[] buffer, int size) {
        double sum = 0;
        for (int i = 0; i < size; i++) {
            double v = buffer[i] / 32768.0;
            sum += v * v;
        }
        return (float) Math.min(1.0, Math.sqrt(sum / Math.max(1, size)) * 8.0);
    }


    private void updatePitch(double frequency, float level, short[] buffer, int size) {
        int midi = nearestMidi(frequency);
        int targetMidi = selectedTargetMidi > 0 ? selectedTargetMidi : midi;
        double target = targetFrequencyForMidi(targetMidi);
        double cents = centsBetween(frequency, target);
        boolean outOfRange = Math.abs(cents) > TUNER_DIAL_CENTS_RANGE;
        boolean pitchReady = isStablePianoPitch(cents, level);
        boolean alarmReady = outOfRange && pitchReady && System.currentTimeMillis() >= suppressRangeAlarmUntilMs;
        latestFrequency = frequency;
        latestMidi = midi;
        latestCents = cents;
        latestPitchMs = System.currentTimeMillis();
        boolean motorPitchReady = pitchReady && motorStrikeGate.acceptStable(SystemClock.elapsedRealtime());
        if (motorPitchReady) {
            latestStableFrequency = frequency;
            latestStableMidi = midi;
            latestStableCents = cents;
            latestStablePitchMs = latestPitchMs;
        }
        String note = noteName(targetMidi);
        runOnUiThread(() -> {
            pitchText.setText(String.format(Locale.US, "Pitch: %s  %.1f Hz", note, frequency));
            targetText.setText(String.format(Locale.US, "Target: %s %.1f Hz   %.1f cents", note, target, cents));
            if (!pitchReady) {
                tunerView.setWaveform(level, buffer, size);
                updatePianoScanUnstable(level);
            } else if (alarmReady) {
                tunerView.setOutOfRangePitch(note, frequency, target, cents, level, buffer, size);
                triggerPitchRangeAlarm();
            } else if (outOfRange) {
                tunerView.setWaveform(level, buffer, size);
            } else {
                tunerView.setPitch(note, frequency, target, cents, level, buffer, size);
            }
            if (pitchReady) {
                handlePianoScanPitch(frequency, midi, cents);
                if (motorPitchReady) {
                    if (autoTuning && !isConfirmedTargetKey(autoTargetMidi, midi)) {
                        triggerSafetyVibration("Wrong key during remeasurement");
                        autoText.setText("Wrong key: allow quiet, then strike the selected key again");
                        armMotorStrike(0);
                    } else handleArmedAutoTunePitch(midi, cents);
                }
            }
        });
    }

    private boolean isStablePianoPitch(double cents, float level) {
        long now = System.currentTimeMillis();
        if (now < suppressPitchUpdateUntilMs || level < 0.045f) {
            pitchCandidateFrames = 0;
            return false;
        }
        if (Math.abs(cents - pitchCandidateCents) > 35.0 || now - pitchCandidateStartedMs > 850L) {
            pitchCandidateCents = cents;
            pitchCandidateFrames = 1;
            pitchCandidateStartedMs = now;
            return false;
        }
        pitchCandidateCents = pitchCandidateCents * 0.65 + cents * 0.35;
        pitchCandidateFrames++;
        return pitchCandidateFrames >= 4 && now - pitchCandidateStartedMs >= 220L;
    }

    private void triggerPitchRangeAlarm() {
        long now = System.currentTimeMillis();
        if (now - lastRangeAlarmVibrateMs < 900) {
            return;
        }
        lastRangeAlarmVibrateMs = now;
        Vibrator vibrator = (Vibrator) getSystemService(Context.VIBRATOR_SERVICE);
        if (vibrator == null) {
            return;
        }
        if (Build.VERSION.SDK_INT >= Build.VERSION_CODES.O) {
            vibrator.vibrate(VibrationEffect.createWaveform(
                    new long[]{0, 70, 80, 120},
                    new int[]{0, 170, 0, 220},
                    -1
            ));
        } else {
            vibrator.vibrate(new long[]{0, 70, 80, 120}, -1);
        }
    }

    private void triggerSafetyVibration(String reason) {
        long now = System.currentTimeMillis();
        if (now - lastSafetyVibrateMs < SAFETY_VIBRATION_COOLDOWN_MS) {
            return;
        }
        lastSafetyVibrateMs = now;
        appendLog(reason);
        Vibrator vibrator = (Vibrator) getSystemService(Context.VIBRATOR_SERVICE);
        if (vibrator == null) {
            return;
        }
        if (Build.VERSION.SDK_INT >= Build.VERSION_CODES.O) {
            vibrator.vibrate(VibrationEffect.createWaveform(
                    new long[]{0, 120, 80, 120, 80, 180},
                    new int[]{0, 220, 0, 220, 0, 255},
                    -1
            ));
        } else {
            vibrator.vibrate(new long[]{0, 120, 80, 120, 80, 180}, -1);
        }
    }

    private void selectTargetMidi(int midi) {
        selectTargetMidi(midi, true);
    }

    private void handleVirtualPianoKeySelected(int midi) {
        int targetMidi = Math.max(21, Math.min(108, midi));
        if (autoTuning && targetMidi == autoTargetMidi) {
            toast("请等待电机停稳，再按实体钢琴键；续调不需要取下棘轮扳手");
            return;
        }
        if (pianoScanActive) {
            selectTargetMidi(targetMidi, true);
            return;
        }
        if (motorSafetyInitInProgress || motorSafetyBackoffInProgress) {
            toast("Motor initialization is running");
            return;
        }
        if (motorSafetyInitialized && motorSafetyInitializedMidi == targetMidi) {
            selectTargetMidi(targetMidi, true);
            armAutoTuneForPianoStrike(targetMidi);
            return;
        }
        showRemoveWrenchDialog(targetMidi);
    }

    private void showRemoveWrenchDialog(int midi) {
        String note = noteName(midi);
        new AlertDialog.Builder(this)
                .setTitle("取下扳手")
                .setMessage("准备调 " + note + "。\n\n"
                        + "请先取下扳手，确认电机和机构可以空载移动。\n\n"
                        + "确认后电机会先向低音侧移动到微动限位开关，再反向转动 10 圈定位。定位完成后再放入扳手。")
                .setNegativeButton("取消", null)
                .setPositiveButton("确认，开始初始化", (dialog, which) -> startMotorSafetyInitialization(midi))
                .show();
    }

    private void startMotorSafetyInitialization(int midi) {
        if (!safeMotor.capable() || gatt == null || activityPaused) {
            toast("需要已确认的安全协议固件；未连接或旧固件禁止初始化");
            return;
        }
        if (safeMotor.pending() != null) {
            failMotorSafety("Stop active operation before rehoming", true);
            return;
        }
        stopAutoTune(false);
        cancelScheduledCommands();
        clearMotorPosition();
        motorWrites.clear();
        selectTargetMidi(midi, false);
        motorSafetyInitializedMidi = midi;
        // Queue an explicit STOP before SPEED/HOME; transport responses preserve
        // ordering even if a previous manual HOLD write was still in flight.
        if (!sendCommand("PRE HOME STOP", CMD_STOP)) return;
        SafeMotorSession.Request request;
        try { request = safeMotor.home(SystemClock.elapsedRealtime()); }
        catch (IllegalStateException ex) { failMotorSafety(ex.getMessage(), true); return; }
        motorSafetyInitInProgress = true;
        motorSafetySeekStartedAtMs = System.currentTimeMillis();
        autoText.setText("Init: waiting for controller START");
        setStatus("Init: tagged ESP32 HOME, remove wrench");
        if (!sendCommand("HOME SPEED", speedCommandForPercent(autoSpeedPercent))
                || !sendCommand("SAFE HOME #" + request.id, request.hex())) {
            failMotorSafety("HOME send rejected; will not retry", true);
            return;
        }
        watchMotorRequest(request, gatt);
    }



    private void startContinuousCommand(String label, String hex, MotionActiveCheck activeCheck, int generation) {
        if (generation != commandGeneration || !activeCheck.isActive()) {
            return;
        }
        sendCommand(label, hex);
        activeMotionRunnable = new Runnable() {
            @Override
            public void run() {
                if (generation != commandGeneration || !activeCheck.isActive()) {
                    return;
                }
                sendCommand(label + " keep", hex);
                handler.postDelayed(this, 130L);
            }
        };
        handler.postDelayed(activeMotionRunnable, 130L);
    }

    private interface MotionActiveCheck {
        boolean isActive();
    }


    private void finishMotorSafetyInitializationFromEsp32() {
        if (activityPaused || !safeMotor.homed()
                || (!motorSafetyInitInProgress && !motorSafetyBackoffInProgress)) {
            return;
        }
        commandGeneration++;
        motorSafetyInitInProgress = false;
        motorSafetyBackoffInProgress = false;
        motorSafetyBackoffOriginLimit = Direction.NONE;
        motorSafetyInitialized = true;
        motorPositionRevFromLow = MOTOR_INIT_BACKOFF_REV;
        currentDirection = Direction.NONE;
        setStatus("Init complete: insert wrench");
        if (autoText != null) {
            autoText.setText("Init: complete, insert wrench");
        }
        new AlertDialog.Builder(this)
                .setTitle("放入扳手")
                .setMessage("初始化完成。\n\n"
                        + "现在请放入扳手，然后点击 APP 虚拟键盘上的 "
                        + noteName(motorSafetyInitializedMidi)
                        + "，再按下实体钢琴键。")
                .setPositiveButton("知道了", null)
                .show();
    }

    private void armMotorStrike(long settleMs) {
        latestStableFrequency = 0;
        latestStablePitchMs = 0;
        pitchCandidateFrames = 0;
        motorStrikeGate.arm(SystemClock.elapsedRealtime(), settleMs);
    }

    private void armAutoTuneForPianoStrike(int midi) {
        autoArmedForPianoStrike = true;
        autoTargetMidi = midi;
        autoTargetFrequency = targetFrequencyForMidi(midi);
        autoIgnorePitchBeforeMs = System.currentTimeMillis() + 250L;
        pitchCandidateFrames = 0;
        armMotorStrike(Math.max(250L, suppressPitchUpdateUntilMs - System.currentTimeMillis()));
        if (autoText != null) {
            autoText.setText("Ready: press the physical piano key");
        }
        setStatus("Ready: press physical " + noteName(midi));
        toast("Press the physical piano key");
    }

    private void selectTargetMidi(int midi, boolean playPreview) {
        selectedTargetMidi = Math.max(21, Math.min(108, midi));
        suppressPitchUpdateUntilMs = System.currentTimeMillis() + 850L;
        suppressRangeAlarmUntilMs = suppressPitchUpdateUntilMs + 250L;
        pitchCandidateFrames = 0;
        String note = noteName(selectedTargetMidi);
        double target = targetFrequencyForMidi(selectedTargetMidi);
        if (targetText != null) {
            targetText.setText(String.format(Locale.US, "Target: %s %.1f Hz", note, target));
        }
        if (tunerView != null) {
            tunerView.setSelectedMidi(selectedTargetMidi, target);
        }
        if (playPreview && keyPreviewEnabled && pianoKeyPlayer != null) {
            suppressPitchUpdateUntilMs = System.currentTimeMillis() + 900L;
            suppressRangeAlarmUntilMs = suppressPitchUpdateUntilMs + 250L;
            pitchCandidateFrames = 0;
            pianoKeyPlayer.play(selectedTargetMidi);
        }
        if (logText != null) {
            appendLog("Selected target " + note + " " + String.format(Locale.US, "%.1f Hz", target));
        }
    }

    private int nearestMidi(double frequency) {
        int midi = (int) Math.round(69 + 12 * Math.log(frequency / 440.0) / Math.log(2));
        return Math.max(21, Math.min(108, midi));
    }

    private double frequencyForMidi(int midi) {
        return 440.0 * Math.pow(2, (midi - 69) / 12.0);
    }

    private double targetFrequencyForMidi(int midi) {
        double base = frequencyForMidi(midi);
        if (!pianoTuningComputed || midi < 21 || midi > 108) {
            return base;
        }
        return base * Math.pow(2.0, pianoTuningOffsetCents[midi] / 1200.0);
    }

    private double centsBetween(double frequency, double target) {
        return 1200.0 * Math.log(frequency / target) / Math.log(2);
    }

    private String noteName(int midi) {
        String[] names = {"C", "C#", "D", "D#", "E", "F", "F#", "G", "G#", "A", "A#", "B"};
        int octave = midi / 12 - 1;
        return names[Math.floorMod(midi, 12)] + octave;
    }

    private boolean hasFreshPitch() {
        return latestFrequency > 0 && System.currentTimeMillis() - latestPitchMs < 2500;
    }

    private boolean hasFreshStablePitchForTarget(int midi) {
        return latestStableFrequency > 0
                && System.currentTimeMillis() - latestStablePitchMs < 2500
                && isConfirmedTargetKey(midi, latestStableMidi);
    }

    private boolean hasNewStablePitchForTarget(int midi, long afterMs) {
        return hasFreshStablePitchForTarget(midi) && latestStablePitchMs >= afterMs;
    }

    private boolean hasFreshStablePitch() {
        return latestStableFrequency > 0 && System.currentTimeMillis() - latestStablePitchMs < 2500;
    }

    private boolean isConfirmedTargetKey(int targetMidi, int detectedMidi) {
        return Math.abs(detectedMidi - targetMidi) <= WRONG_KEY_ALLOWED_SEMITONES;
    }

    private void handleArmedAutoTunePitch(int detectedMidi, double cents) {
        if (!autoArmedForPianoStrike || System.currentTimeMillis() < autoIgnorePitchBeforeMs) {
            return;
        }
        if (!isConfirmedTargetKey(autoTargetMidi, detectedMidi)) {
            triggerSafetyVibration("Wrong key");
            autoText.setText("Wrong key: heard " + noteName(detectedMidi) + ", target " + noteName(autoTargetMidi));
            setStatus("Wrong key: press " + noteName(autoTargetMidi));
            armMotorStrike(0);
            return;
        }
        if (!isCentsWithinMotorRange(autoTargetMidi, cents)) {
            triggerSafetyVibration("Pitch out of motor range");
            autoText.setText(String.format(Locale.US, "Out of range: %+.1f cents", cents));
            setStatus("Pitch out of motor range");
            armMotorStrike(0);
            return;
        }
        autoArmedForPianoStrike = false;
        startAutoTune();
    }

    private double availableRevForDirection(Direction direction) {
        double position = Double.isNaN(motorPositionRevFromLow) ? MOTOR_INIT_BACKOFF_REV : motorPositionRevFromLow;
        if (direction == Direction.RIGHT) {
            return Math.max(0.0, MOTOR_TOTAL_TRAVEL_REV - position);
        }
        if (direction == Direction.LEFT) {
            return Math.max(0.0, position);
        }
        return 0.0;
    }

    private boolean isCentsWithinMotorRange(int midi, double cents) {
        Direction needed = cents < 0 ? Direction.RIGHT : Direction.LEFT;
        double availableRev = availableRevForDirection(needed);
        double maxCents = experienceBaseCentsPerRev(midi) * experienceScaleForMidi(midi) * availableRev;
        return Math.abs(cents) <= maxCents + autoToleranceCents;
    }

    private double experienceBaseCentsPerRev(int midi) {
        int clamped = Math.max(EXPERIENCE_CURVE_MIDI[0],
                Math.min(EXPERIENCE_CURVE_MIDI[EXPERIENCE_CURVE_MIDI.length - 1], midi));
        for (int i = 0; i < EXPERIENCE_CURVE_MIDI.length - 1; i++) {
            int leftMidi = EXPERIENCE_CURVE_MIDI[i];
            int rightMidi = EXPERIENCE_CURVE_MIDI[i + 1];
            if (clamped <= rightMidi) {
                double t = (clamped - leftMidi) / (double) (rightMidi - leftMidi);
                return EXPERIENCE_CURVE_CENTS_PER_REV[i]
                        + (EXPERIENCE_CURVE_CENTS_PER_REV[i + 1] - EXPERIENCE_CURVE_CENTS_PER_REV[i]) * t;
            }
        }
        return EXPERIENCE_CURVE_CENTS_PER_REV[EXPERIENCE_CURVE_CENTS_PER_REV.length - 1];
    }

    private double experienceScaleForMidi(int midi) {
        if (midi < 21 || midi > 108 || autoExperienceScale[midi] <= 0) {
            return 1.0;
        }
        return autoExperienceScale[midi];
    }

    private double experienceCentsPerSecond(int midi) {
        double revPerSecond = EXPERIENCE_MOTOR_RPM / 60.0;
        return Math.max(0.1, experienceBaseCentsPerRev(midi) * experienceScaleForMidi(midi) * revPerSecond);
    }

    private int experienceDurationMs(int midi, double centsError) {
        double rawMs = Math.abs(centsError) / experienceCentsPerSecond(midi) * 1000.0;
        return clampInt((int) Math.round(rawMs), EXPERIENCE_MIN_PULSE_MS, autoExperienceMaxPulseMs);
    }

    private boolean learnExperienceScale(double currentCents) {
        if (autoLastDirection == Direction.NONE || Math.abs(autoLastExpectedDeltaCents) < 0.1) {
            return true;
        }
        double actualDelta = currentCents - autoLastObservedCents;
        TuningResponseSafety.Result result = TuningResponseSafety.evaluate(autoLastExpectedDeltaCents, actualDelta);
        if (result != TuningResponseSafety.Result.CONSISTENT) {
            appendLog(String.format(Locale.US,
                    "Auto response rejected (%s): expected %+.2f cents, actual %+.2f cents",
                    result,
                    autoLastExpectedDeltaCents,
                    actualDelta));
            stopAutoTune(true);
            autoArmedForPianoStrike = false;
            triggerSafetyVibration("Unexpected tuning response: " + result);
            autoText.setText("Auto stopped: unexpected response. Check direction/backlash and remeasure.");
            setStatus("音高变化异常，已停止。请检查方向/间隙并重新击键确认；不会自动反转。");
            return false;
        }
        double measuredFactor = Math.abs(actualDelta / autoLastExpectedDeltaCents);
        measuredFactor = clampDouble(measuredFactor, 0.25, 4.0);
        double oldScale = experienceScaleForMidi(autoTargetMidi);
        double newScale = clampDouble(oldScale * 0.65 + oldScale * measuredFactor * 0.35, 0.25, 4.0);
        autoExperienceScale[autoTargetMidi] = newScale;
        saveCalibrationSettings();
        appendLog(String.format(Locale.US,
                "Auto learn %s: expected %+.2f, actual %+.2f, scale %.3f -> %.3f",
                noteName(autoTargetMidi),
                autoLastExpectedDeltaCents,
                actualDelta,
                oldScale,
                newScale));
        return true;
    }

    private void startAutoTune() {
        if (!safeMotor.capable() || !safeMotor.homed() || safeMotor.pending() != null || activityPaused) {
            toast("需要安全协议固件、有效初始化且电机空闲；禁止旧协议自动调音");
            return;
        }
        if (!hasAudioPermission()) {
            requestNeededPermissions();
            return;
        }
        if (!listening) {
            startPitchListening();
        }
        if (gatt == null || writeCharacteristic == null) {
            toast("请先连接蓝牙电机板");
            return;
        }
        int targetMidi = selectedTargetMidi > 0 ? selectedTargetMidi : latestMidi;
        if (!motorSafetyInitialized || motorSafetyInitializedMidi != targetMidi) {
            toast("请先点击虚拟键并完成电机初始化");
            autoText.setText("自动：请先初始化电机");
            showRemoveWrenchDialog(targetMidi);
            return;
        }
        if (hasFreshStablePitch() && !isConfirmedTargetKey(targetMidi, latestStableMidi)) {
            triggerSafetyVibration("Wrong key");
            autoText.setText("Wrong key: heard " + noteName(latestStableMidi));
            return;
        }
        if (!hasFreshStablePitchForTarget(targetMidi)) {
            armAutoTuneForPianoStrike(targetMidi);
            autoText.setText("Auto: allow quiet, then strike the selected physical key");
            return;
        }

        sourceReady();
        autoTuning = true;
        autoGeneration++;
        autoStepCount = 0;
        autoTargetMidi = targetMidi;
        autoTargetFrequency = targetFrequencyForMidi(autoTargetMidi);
        autoRaiseDirection = Direction.RIGHT;
        autoLowerDirection = Direction.LEFT;
        autoWaitingForRestrike = false;
        autoLastDirection = Direction.NONE;
        autoIgnorePitchBeforeMs = 0;
        autoArmedForPianoStrike = false;
        autoText.setText("Auto: experience model ready");
        appendLog(String.format(Locale.US,
                "Auto experience target %s %.2f Hz, curve %.3f cents/rev",
                noteName(autoTargetMidi),
                autoTargetFrequency,
                experienceBaseCentsPerRev(autoTargetMidi)));
        applyExperienceAdjustment(false);
    }


    private void autoAdjustLoop() {
        if (!autoTuning) {
            return;
        }
        if (safeMotor.pending() != null) return;
        if (safeMotor.ratchetEligible()) {
            continueRatchetAfterRemeasurement();
            return;
        }
        if (!safeMotor.homed()) {
            failMotorSafety("Home position is no longer valid", true);
            return;
        }
        if (autoWaitingForRestrike) {
            if (!hasNewStablePitchForTarget(autoTargetMidi, autoIgnorePitchBeforeMs)) {
                autoText.setText("Auto: play the physical key again");
                scheduleAuto(this::autoAdjustLoop, 350);
                return;
            }
            applyExperienceAdjustment(true);
            return;
        }
        applyExperienceAdjustment(false);
    }

    private void applyExperienceAdjustment(boolean learnFromLastMove) {
        if (!autoTuning) {
            return;
        }
        if (++autoStepCount > autoMaxStepsSetting) {
            autoText.setText("Auto: stopped, max steps");
            stopAutoTune(true);
            return;
        }
        if (!hasFreshStablePitchForTarget(autoTargetMidi)) {
            autoText.setText("Auto: waiting for stable key strike");
            scheduleAuto(this::autoAdjustLoop, 1000);
            return;
        }

        double cents = centsBetween(latestStableFrequency, autoTargetFrequency);
        if (learnFromLastMove && !learnExperienceScale(cents)) {
            return;
        }
        if (!isCentsWithinMotorRange(autoTargetMidi, cents)) {
            triggerSafetyVibration("Pitch out of motor range");
            autoText.setText(String.format(Locale.US, "Auto: out of range %+.1f cents", cents));
            stopAutoTune(true);
            return;
        }
        if (Math.abs(cents) <= autoToleranceCents) {
            String doneMessage = String.format(Locale.US, "Auto: done %.1f cents", cents);
            if (tunerView != null) {
                tunerView.showCalibrationComplete();
            }
            stopAutoTune(true);
            autoText.setText(doneMessage);
            return;
        }

        Direction direction = cents < 0 ? autoRaiseDirection : autoLowerDirection;
        if (safeMotor.supportsRatchet() && cents > autoToleranceCents) {
            failMotorSafety("Pitch is sharp: raising ratchet cannot auto-lower; check selector manually", true);
            return;
        }
        if (direction == Direction.NONE) {
            autoText.setText("Auto: direction unknown");
            stopAutoTune(true);
            return;
        }

        int correctionMs = experienceDurationMs(autoTargetMidi, cents);
        int preloadMs = direction == autoRaiseDirection
                ? (int) Math.round(autoPreloadLowRev * EXPERIENCE_REV_MS)
                : 0;
        preloadMs = Math.min(preloadMs, (int) Math.floor(availableRevForDirection(autoLowerDirection) * EXPERIENCE_REV_MS));
        int duration = correctionMs + preloadMs;
        int availableMs = (int) Math.floor(availableRevForDirection(direction) * EXPERIENCE_REV_MS);
        if (duration > availableMs) {
            duration = availableMs;
        }
        int netCorrectionMs = direction == autoRaiseDirection ? duration - preloadMs : duration;
        if (duration < EXPERIENCE_MIN_PULSE_MS || netCorrectionMs < EXPERIENCE_MIN_PULSE_MS) {
            triggerSafetyVibration("Motor travel exhausted");
            autoText.setText("Auto: motor travel exhausted");
            stopAutoTune(true);
            return;
        }
        double centsPerSecond = experienceCentsPerSecond(autoTargetMidi);
        double expectedCents = centsPerSecond * netCorrectionMs / 1000.0;
        autoLastExpectedDeltaCents = direction == autoRaiseDirection ? expectedCents : -expectedCents;
        autoLastObservedCents = cents;
        autoLastDurationMs = duration;
        autoLastDirection = direction;
        autoText.setText(String.format(Locale.US,
                "Auto: %+.1f cents, preload %.1f rev, %s %d ms (%.2f cents/rev)",
                cents,
                preloadMs / EXPERIENCE_REV_MS,
                directionName(direction),
                duration,
                centsPerSecond));
        if (!autoPulseWithPreload(direction, duration, preloadMs)) {
            stopAutoTune(true);
            return;
        }
        // Position updates and restrike scheduling happen ONLY on matching MOVE_DONE.
    }


    private void continueRatchetAfterRemeasurement() {
        if (!hasNewStablePitchForTarget(autoTargetMidi, autoIgnorePitchBeforeMs)) {
            autoText.setText("High limit: play the selected physical key to confirm pitch");
            scheduleAuto(this::autoAdjustLoop, 350L);
            return;
        }
        double cents = centsBetween(latestStableFrequency, autoTargetFrequency);
        if (Math.abs(cents) <= autoToleranceCents) {
            stopAutoTune(true);
            tunerView.showCalibrationComplete();
            autoText.setText(String.format(Locale.US, "Auto: done %.1f cents", cents));
            return;
        }
        if (cents > 0 || cents < -TUNER_DIAL_CENTS_RANGE || cents < autoLastObservedCents - 2.0) {
            failMotorSafety("Ratchet continuation rejected: sharp, out-of-range or unexpected pitch", true);
            return;
        }
        SafeMotorSession.Request request;
        try { request = safeMotor.ratchet(SystemClock.elapsedRealtime()); }
        catch (IllegalStateException ex) { failMotorSafety(ex.getMessage(), true); return; }
        autoLastDirection = Direction.NONE;
        autoWaitingForRestrike = false;
        currentDirection = Direction.LEFT;
        motorStrikeGate.cancel();
        latestStablePitchMs = 0;
        autoText.setText("Ratchet freewheel return to low limit (" + safeMotor.ratchetCycles()
                + "/" + SafeMotorSession.MAX_RATCHET_CYCLES + "); this is not pitch lowering");
        if (!sendCommand("SAFE RATCHET #" + request.id, request.hex())) {
            failMotorSafety("Ratchet send rejected; no retry", true);
            return;
        }
        watchMotorRequest(request, gatt);
    }

    private boolean autoPulseWithPreload(Direction direction, int durationMs, int preloadMs) {
        if (!safeMotor.capable() || !safeMotor.homed() || safeMotor.pending() != null
                || Double.isNaN(motorPositionRevFromLow) || activityPaused) return false;
        if (direction == Direction.NONE || direction == blockedDirection) return false;
        Direction preloadDirection = direction == Direction.LEFT ? Direction.RIGHT : Direction.LEFT;
        if (preloadMs > 0 && preloadDirection == blockedDirection) return false;
        SafeMotorSession.Request request;
        try {
            request = safeMotor.move(direction == Direction.LEFT ? 1 : 2,
                    durationMs, preloadMs, SystemClock.elapsedRealtime());
        } catch (IllegalArgumentException | IllegalStateException ex) {
            failMotorSafety(ex.getMessage(), true);
            return false;
        }
        currentDirection = direction;
        autoWaitingForRestrike = false;
        motorStrikeGate.cancel();
        latestStablePitchMs = 0;
        if (!sendCommand("SAFE MOVE #" + request.id, request.hex())) {
            failMotorSafety("Timed move send rejected; no retry", true);
            return false;
        }
        watchMotorRequest(request, gatt);
        return true;
    }

    private void updateMotorPositionAfterMove(Direction direction, int durationMs) {
        if (direction == Direction.NONE) {
            return;
        }
        double position = Double.isNaN(motorPositionRevFromLow) ? MOTOR_INIT_BACKOFF_REV : motorPositionRevFromLow;
        double movedRev = durationMs / EXPERIENCE_REV_MS;
        if (direction == Direction.RIGHT) {
            position += movedRev;
        } else if (direction == Direction.LEFT) {
            position -= movedRev;
        }
        motorPositionRevFromLow = clampDouble(position, 0.0, MOTOR_TOTAL_TRAVEL_REV);
        appendLog(String.format(Locale.US,
                "Motor position %.2f/%.0f rev from low limit",
                motorPositionRevFromLow,
                MOTOR_TOTAL_TRAVEL_REV));
    }

    private void scheduleAuto(Runnable runnable, long delayMs) {
        int generation = autoGeneration;
        handler.postDelayed(() -> {
            if (autoTuning && generation == autoGeneration) {
                runnable.run();
            }
        }, delayMs);
    }

    private void stopAutoTune(boolean sendStop) {
        autoTuning = false;
        autoArmedForPianoStrike = false;
        motorStrikeGate.cancel();
        latestStablePitchMs = 0;
        autoGeneration++;
        autoWaitingForRestrike = false;
        autoLastDirection = Direction.NONE;
        currentDirection = Direction.NONE;
        if (autoText != null && !"Auto: done".contentEquals(autoText.getText())) {
            autoText.setText("Auto: idle");
        }
        if (sendStop && gatt != null && writeCharacteristic != null) {
            sendCommand("AUTO STOP", CMD_STOP);
        }
    }

    private String deviceLabel(BluetoothDevice device) {
        String name = safeDeviceName(device);
        return ((name == null || name.length() == 0) ? "(no name)" : name) + " / " + device.getAddress();
    }

    @SuppressLint("MissingPermission")
    private String safeDeviceName(BluetoothDevice device) {
        if (device == null || !hasConnectPermission()) {
            return null;
        }
        try {
            return device.getName();
        } catch (SecurityException ex) {
            return null;
        }
    }

    private boolean isTargetMotorName(String name) {
        if (name == null) {
            return false;
        }
        String normalized = name.trim().toUpperCase(Locale.US);
        return normalized.equals(TARGET_NAME.toUpperCase(Locale.US));
    }

    private String firstNonEmpty(String first, String second) {
        if (first != null && first.trim().length() > 0) {
            return first;
        }
        if (second != null && second.trim().length() > 0) {
            return second;
        }
        return null;
    }

    private String valueOrDash(String value) {
        return value == null || value.trim().length() == 0 ? "-" : value;
    }

    private void requestNeededPermissions() {
        List<String> permissions = new ArrayList<>();
        if (Build.VERSION.SDK_INT >= Build.VERSION_CODES.S) {
            permissions.add(Manifest.permission.BLUETOOTH_SCAN);
            permissions.add(Manifest.permission.BLUETOOTH_CONNECT);
        }
        permissions.add(Manifest.permission.ACCESS_FINE_LOCATION);
        permissions.add(Manifest.permission.RECORD_AUDIO);

        List<String> missing = new ArrayList<>();
        for (String permission : permissions) {
            if (checkSelfPermission(permission) != PackageManager.PERMISSION_GRANTED) {
                missing.add(permission);
            }
        }
        if (!missing.isEmpty()) {
            requestPermissions(missing.toArray(new String[0]), REQUEST_PERMISSIONS);
        }
    }

    @Override
    public void onRequestPermissionsResult(int requestCode, String[] permissions, int[] grantResults) {
        super.onRequestPermissionsResult(requestCode, permissions, grantResults);
        if (requestCode == REQUEST_PERMISSIONS && hasAudioPermission()) {
            startPitchListening();
        }
    }

    private boolean hasScanPermission() {
        if (Build.VERSION.SDK_INT >= Build.VERSION_CODES.S) {
            return checkSelfPermission(Manifest.permission.BLUETOOTH_SCAN) == PackageManager.PERMISSION_GRANTED
                    && checkSelfPermission(Manifest.permission.ACCESS_FINE_LOCATION) == PackageManager.PERMISSION_GRANTED;
        }
        return checkSelfPermission(Manifest.permission.ACCESS_FINE_LOCATION) == PackageManager.PERMISSION_GRANTED;
    }

    private boolean hasConnectPermission() {
        return Build.VERSION.SDK_INT < Build.VERSION_CODES.S
                || checkSelfPermission(Manifest.permission.BLUETOOTH_CONNECT) == PackageManager.PERMISSION_GRANTED;
    }

    private boolean hasAudioPermission() {
        return checkSelfPermission(Manifest.permission.RECORD_AUDIO) == PackageManager.PERMISSION_GRANTED;
    }

    private static class TunerDisplayView extends View {
        private final Paint paint = new Paint(Paint.ANTI_ALIAS_FLAG);
        private final RectF arc = new RectF();
        private String note = "--";
        private double frequency;
        private double target;
        private double cents;
        private float level;
        private final short[] wave = new short[256];

        TunerDisplayView(Context context) {
            super(context);
            paint.setTypeface(android.graphics.Typeface.DEFAULT_BOLD);
        }

        void setLevel(float value) {
            level = value;
            invalidate();
        }

        void setPitch(String note, double frequency, double target, double cents, float level, short[] buffer, int size) {
            this.note = note;
            this.frequency = frequency;
            this.target = target;
            this.cents = Math.max(-TUNER_DIAL_CENTS_RANGE, Math.min(TUNER_DIAL_CENTS_RANGE, cents));
            this.level = level;
            int step = Math.max(1, size / wave.length);
            for (int i = 0; i < wave.length; i++) {
                wave[i] = buffer[Math.min(size - 1, i * step)];
            }
            invalidate();
        }

        @Override
        protected void onDraw(Canvas canvas) {
            super.onDraw(canvas);
            int w = getWidth();
            int h = getHeight();
            canvas.drawColor(Color.WHITE);
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
