maxtom400-lab/Electric-piano-tuning/(commit log)

2026-06-09 Update README.md
    A mobile phone utilizes a Bluetooth module to drive a low-power 12V brushed motor—connected to a Bluetooth control board—to achieve forward and reverse rotation. The motor is mounted on the piano's cast-iron frame, with the tuning lever positioned within the motor's U-shaped slot; the motor's linear motion drives the movement of the lever. The entire adjustment mechanism automatically rotates around an axis fixed to the cast-iron frame, thereby driving the tuning wrench to rotate around the piano's tuning pin and enabling precise tuning.
2026-06-09 app
    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
2026-06-11 Add piano mounting bracket reference
2026-06-11 Add auto tune safety and calibration settings
2026-06-12 Fix rotating dial layer sizing and animation
    [MainActivity.java]
2026-10-07 Update waveform tuning app and ESP32 motor firmware; credit open-source authors
2026-10-07 Document ESP32 tuning prototype and credit open-source authors
2026-10-07 Update waveform tuning and ESP32 homing workflow
2026-10-07 Add ESP32-C3 motor and limit-switch firmware
2026-10-26 Add fail-safe timed motor control and ratchet stroke recovery
2026-10-27 Accelerate piano pitch detection with tested FFT core and safe PCM framing
